frillip/gps-vfd-desk-clock/hardware/v2_0/smol_clock_2_0_bom_top.xlsx

No. | Quantity | Comment | Designator | Footprint | Value | Manufacturer Part | Manufacturer | Supplier Part | Supplier
1 | 2 | 100nF | C9,C25 | C0805 |  | CL21B104KCFNNNE | SAMSUNG(三星) | C28233 | LCSC
2 | 2 | 100nF | C33,C34 | C0402 |  | CL05B104KO5NNNC | SAMSUNG(三星) | C1525 | LCSC
3 | 1 | 2.54-2*4P立贴针 | H1 | HDR-SMD_8P-P2.54-V-M-R2-C4-LS7.4 |  | 2.54-2*4P立贴针 | BOOMELE(博穆精密) | C192300 | LCSC
4 | 4 | IV-12 VFD Tube_2MM | N1,N2,N3,N4 | IV-12 VFD TUBE 2MM PINS
5 | 2 | IV-1 VFD Tube | N5,N6 | IV-1
6 | 2 | 12Ω | R7,R8 | R0805 |  | AS05W2J0120T5E | UNI-ROYAL(厚声) | C966145 | LCSC
7 | 2 | HV5812WG-G | U9,U10 | SOIC-28_L18.0-W7.5-P1.27-LS10.3-BL |  | HV5812WG-G | Microchip Tech | C219183 | LCSC
