frillip/gps-vfd-desk-clock/hardware/v2_0/smol_clock_2_0_bom_bottom.xlsx

No. | Quantity | Comment | Designator | Footprint | Value | Manufacturer Part | Manufacturer | Supplier Part | Supplier
1 | 6 | JUMPER | 3V3_LED,E_LED,G_LED,S_LED,VG_LED,VU_LED | PAD-JUMPER-2-NC_BY_TRACE_YES_SILK
2 | 1 | BUZZER 9.6MM | BUZZER1 | BUZ-TH_BD9.6-P5.00-D0.7-FD
3 | 29 | 100nF | C1,C2,C4,C5,C7,C10,C11,C13,C14,C15,C16,C18,C20,C23,C24,C26,C28,C29,C30,C31,C36,C37,C38,C39,C42,C43,C44,C45,C52 | C0402 |  | CL05B104KO5NNNC | SAMSUNG(三星) | C1525 | LCSC
4 | 1 | 22uF | C3 | C0603 |  | CL10A226MQ8NRNC | SAMSUNG(三星) | C59461 | LCSC
5 | 1 | 10uF | C6 | CAP-SMD_BD6.3-L6.6-W6.6-FD |  | RVT2A100M0607 | ROQANG(容强) | C72482 | LCSC
6 | 2 | 100nF | C8,C51 | C0805 |  | CL21B104KCFNNNE | SAMSUNG(三星) | C28233 | LCSC
7 | 1 | 47pF | C12 | C0402 |  | 0402CG470J500NT | FH(风华) | C1567 | LCSC
8 | 1 | 10uF | C17 | CAP-SMD_L3.2-W1.6-R-RD |  | TC212A106K016Y | Sunlord | C108529 | LCSC
9 | 2 | 1uF | C19,C21 | C0603 |  | CL10A105KB8NNNC | SAMSUNG(三星) | C15849 | LCSC
10 | 1 | 100pF | C22 | C0402 |  | 500R07N101JV4T | JOHANSON(约翰逊) | C431654 | LCSC
11 | 2 | 4.7uF | C27,C50 | C0603 |  | CL10A475KO8NNNC | SAMSUNG(三星) | C19666 | LCSC
12 | 3 | 22uF | C32,C46,C47 | C0805 |  | CL21A226MAQNNNE | SAMSUNG(三星) | C45783 | LCSC
13 | 1 | 390pF | C35 | C0402 |  | CC0402KRX7R9BB391 | YAGEO(国巨) | C114397 | LCSC
14 | 2 | 22nF | C40,C41 | C0402 |  | CC0402KRX7R9BB223 | YAGEO(国巨) | C107026 | LCSC
15 | 2 | 10uF | C48,C49 | C0603 |  | CL10A106MA8NRNC | SAMSUNG(三星) | C96446 | LCSC
16 | 1 | HARWIN S8411-45R | CR1220 | HARWIN_S8411-45R |  | S8411-45R | HARWIN | 2115306 | Element14
17 | 2 | 1N5819WS | D1,D6 | SOD-323_L1.8-W1.3-LS2.5-RD |  | 1N5819WS | Hottech(合科泰) | C191023 | LCSC
18 | 2 | SP0503BAHTG | D2,D3 | SOT-143_L2.9-W1.3-P1.92-LS2.3-BR |  | SP0503BAHTG | Littelfuse(美国力特) | C7074 | LCSC
19 | 2 | PSBD1DF40V2L | D4,D9 | SOD-123FL_L2.8-W1.8-LS3.8-RD |  | PSBD1DF40V2L | Prisemi(芯导) | C496544 | LCSC
20 | 1 | PESD0402-140 | D5 | D0402-BI |  | PESD0402-140 | Littelfuse(美国力特) | C10662 | LCSC
21 | 1 | TC2030-NL-FTDI-TTL-232R | ESP | TC2030-IDC-NL |  | TC2030-NL-FTDI-TTL-232R | Tag-Connect | TC2030-NL-FTDI-TTL-232R | TAG-CONNECT
22 | 2 | JUMPER | G_RX,G_TX | SMT-JUMPER_2_NO_SILK
23 | 1 | PM254V-12-08-H85_C2834799 | H2 | HDR-TH_8P-P2.54-V-F-R2-C4-S2.54 |  | PM254V-12-08-H85 | XFCN(台湾兴飞) | C2834799 | LCSC
24 | 1 | 47nH | L1 | L0402 |  | LQW15AN47NG00D | muRata(村田) | C22334 | LCSC
25 | 2 | 3.3uH | L2,L3 | IND-SMD_L2.5-W2.0 |  | SPM2512-3R3M | KOHERelec(科或) | C2761860 | LCSC
26 | 1 | 15uH | L4 | IND-SMD_L5.0-W5.0 |  | FNR5040S150MT | cjiang(长江微电) | C167969 | LCSC
27 | 5 | 19-217/R6C-AL1M2VY/3T | LED1,LED3,LED4,LED5,LED7 | LED0603-R-RD |  | 19-217/R6C-AL1M2VY/3T | EVERLIGHT | C72044 | LCSC
28 | 1 | 19-217/BHC-ZL1M2RY/3T | LED2 | LED0603-FD_BLUE |  | 19-217/BHC-ZL1M2RY/3T | EVERLIGHT(亿光) | C72041 | LCSC
29 | 1 | TC2030-MCP-NL-10 NO PCB LINES | PICKIT | TC2030-IDC-NL |  | TC2030-MCP-NL-10 | Tag-Connect LLC | TC2030-MCP-NL-10-ND | Digi-Key
30 | 1 | BC847BDW1T1G | Q1 | SOT-363_L2.0-W1.3-P0.65-LS2.1-TL |  | BC847BDW1T1G | onsemi(安森美) | C82368 | LCSC
31 | 1 | AO3400A | Q2 | SOT-23-3_L2.9-W1.6-P1.90-LS2.8-BR |  | AO3400A | AOS | C20917 | LCSC
32 | 8 | 1kΩ | R1,R6,R12,R13,R14,R33,R49,R52 | R0603 |  | 0603WAF1001T5E | UNI-ROYAL(厚声) | C21190 | LCSC
33 | 1 | 10Ω | R2 | R0603 |  | RT0603DRD0710RL | YAGEO(国巨) | C700510 | LCSC
34 | 5 | 5.1kΩ | R3,R24,R25,R26,R47 | R0402 |  | 0402WGF5101TCE | UNI-ROYAL(厚声) | C25905 | LCSC
35 | 4 | 10kΩ | R4,R5,R9,R10 | R0402 |  | 0402WGF1002TCE | UniOhm | C25744 | LCSC
36 | 3 | 4.7kΩ | R15,R16,R31 | R0402 |  | 0402WGF4701TCE | UNI-ROYAL(厚声) | C25900 | LCSC
37 | 4 | 33Ω | R17,R18,R19,R20 | R0402 |  | 0402WGF330JTCE | UNI-ROYAL(厚声) | C25105 | LCSC
38 | 4 | 27Ω | R21,R22,R40,R41 | R0402 |  | 0402WGF270JTCE | UNI-ROYAL(厚声) | C25100 | LCSC
39 | 1 | 100kΩ | R23 | R0402 |  | 0402WGF1003TCE | UNI-ROYAL(厚声) | C25741 | LCSC
40 | 1 | 22kΩ | R27 | R0805 |  | 0805W8F2202T5E | UNI-ROYAL(厚声) | C17560 | LCSC
41 | 1 | 274kΩ | R28 | R0402 |  | 0402WGF2743TCE | UNI-ROYAL(厚声) | C27004 | LCSC
42 | 8 | 10kΩ | R29,R32,R36,R37,R42,R44,R50,R53 | R0402 |  | 0402WGF1002TCE | UNI-ROYAL(厚声) | C25744 | LCSC
43 | 1 | 8.87kΩ | R30 | R0402 |  | 0402WGF8871TCE | UNI-ROYAL(厚声) | C36953 | LCSC
44 | 4 | 0Ω | R34,R35,R38,R39 | R0402 |  | 0402WGF0000TCE | UNI-ROYAL(厚声) | C17168 | LCSC
45 | 1 | 38.3kΩ | R43 | R0402 |  | 0402WGF3832TCE | UNI-ROYAL(厚声) | C26976 | LCSC
46 | 1 | 47.5kΩ | R45 | R0402 |  | 0402WGF4752TCE | UNI-ROYAL(厚声) | C25896 | LCSC
47 | 1 | 22.1kΩ | R46 | R0402 |  | 0402WGF2212TCE | UNI-ROYAL(厚声) | C43473 | LCSC
48 | 1 | 330Ω | R48 | R0402 |  | 0402WGF3300TCE | UNI-ROYAL(厚声) | C25104 | LCSC
49 | 1 | 17.4kΩ | R51 | R0402 |  | 0402WGF1742TCE | UNI-ROYAL(厚声) | C26957 | LCSC
50 | 1 | 1kΩ | R54 | R0402 |  | 0402WGF1001TCE | UNI-ROYAL(厚声) | C11702 | LCSC
51 | 1 | BWSMA-KE-P001 | RF1 | SMA-SMD_BWSMA-KE-P001_0.5MMPIN |  | BWSMA-KE-P001 | BAT WIRELESS(蝙蝠无线) | C496550 | LCSC
52 | 1 | TS-1093A-A10B3-D2 | SW1 | KEY-TH_4P-L7.1-W11.4-P4.50-LS2.5 |  | TS-1093A-A10B3-D2 | Yuandi | C499317 | LCSC
53 | 1 | K3-1260D-F1 | SW2 | SW-TH_K3-1260D-F1 |  | K3-1260D-F1 | Korean Hroparts Elec | C223843 | LCSC
54 | 1 | SN74AHC1G04DBVR | U1 | SOT-23-5_L3.0-W1.7-P0.95-LS2.8-BR |  | SN74AHC1G04DBVR | TI | C7465 | LCSC
55 | 1 | LM3671MFX-3.3/NOPB | U2 | SOT-23-5_L3.0-W1.7-P0.95-LS2.8-BL |  | LM3671MFX-3.3/NOPB | TI(德州仪器) | C477918 | LCSC
56 | 1 | DSPIC33EP64GP504-I/PT | U3 | TQFP-44_L10.0-W10.0-P0.80-LS12.0-BL |  | DSPIC33EP64GP504-I/PT | MICROCHIP(美国微芯) | C1337713 | LCSC
57 | 1 | SN74LV4T125PWR | U4 | TSSOP-14_L5.0-W4.4-P0.65-LS6.4-BL |  | SN74LV4T125PWR | TI(德州仪器) | C90755 | LCSC
58 | 1 | TPS55340RTER | U5 | VQFN-16_L3.0-W3.0-P0.50-BL-EP1.7 |  | TPS55340RTER | TI(德州仪器) | C169167 | LCSC
59 | 1 | PCF8563TS/5,118 | U6 | TSSOP-8_L3.0-W3.0-P0.65-LS4.9-BL |  | PCF8563TS/5,118 | NXP(恩智浦) | C27397 | LCSC
60 | 1 | ESP32-WROOM-32E(16MB) | U7 | WIFI-SMD_ESP32-WROOM-32E |  | ESP32-WROOM-32E-N16 | ESPRESSIF(乐鑫) | C701343 | LCSC
61 | 1 | BME280 | U8 | LGA-8_BME280_BL |  | BME280 | Bosch(博世) | C92489 | LCSC
62 | 1 | CP2102N-A02-GQFN28R | U11 | QFN-28_L5.0-W5.0-P0.50-TL-EP3.3 |  | CP2102N-A02-GQFN28R | SILICON LABS(芯科) | C964632 | LCSC
63 | 1 | SN74LVC1G32DBVR | U12 | SOT-23-5_L3.0-W1.7-P0.95-LS2.8-BR |  | SN74LVC1G32DBVR | TI | C10096 | LCSC
64 | 1 | SN74AHCT1G04DBVR | U13 | SOT-23-5_L3.0-W1.7-P0.95-LS2.8-BR |  | SN74AHCT1G04DBVR | TI | C30326 | LCSC
65 | 1 | VEML6040A3OG | U14 | SENSOR_SMD_VEML6040A3OG |  | VEML6040A3OG | VISHAY(威世) | C78465 | LCSC
66 | 1 | LM2831ZMF/NOPB | U15 | SOT-23-5_L2.9-W1.6-P0.95-LS2.8-BR |  | LM2831ZMF/NOPB | TI(德州仪器) | C2070726 | LCSC
67 | 1 | TPS2113ADRBR | U16 | SON-8_L3.0-W3.0-P0.65-LS3.0-BL-EP |  | TPS2113ADRBR | TI(德州仪器) | C354512 | LCSC
68 | 1 | NEO-M9N | U21 | NEO-M9N |  | NEO-M9N | UBLOX | NEO-M9N | UBLOX
69 | 1 | HC-TYPE-C-16P-01A-L | USB1 | USB-C-SMD_G-SWITCH_GT-USB-7010EN |  | HC-TYPE-C-16P-01A-L | HCTL(华灿天禄) | C2997432 | LCSC
70 | 1 | HC-TYPE-C-16P-01A-O | USB2 | USB-C-SMD_G-SWITCH_GT-USB-7010EN |  | HC-TYPE-C-16P-01A-O | HCTL(华灿天禄) | C2997434 | LCSC
71 | 1 | 32.768kHz | X1 | FC-12M_L2.0-W1.2 |  | X1A0000610006 | EPSON(爱普生) | C99009 | LCSC
72 | 1 | 40MHz | X2 | OSC-SMD_4P-L5.0-W3.2-BL_SG-8101CB |  | SG-8101CB 40.000000MHz TBGSA | EPSON(爱普生) | C390561 | LCSC
