frillip/gps-vfd-desk-clock/hardware/v2_0/smol_clock_2_0_schematic.pdf

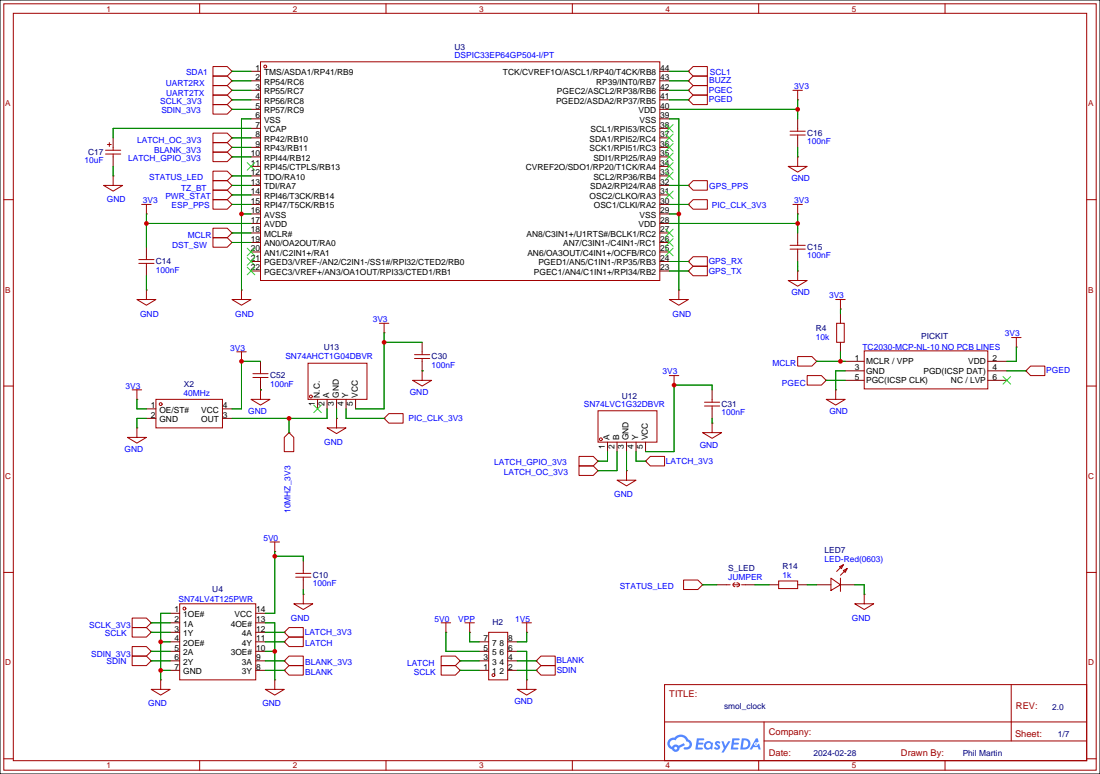
[picture p1: page 1]

TC2030-MCP-NL-10 NO PCB LINES

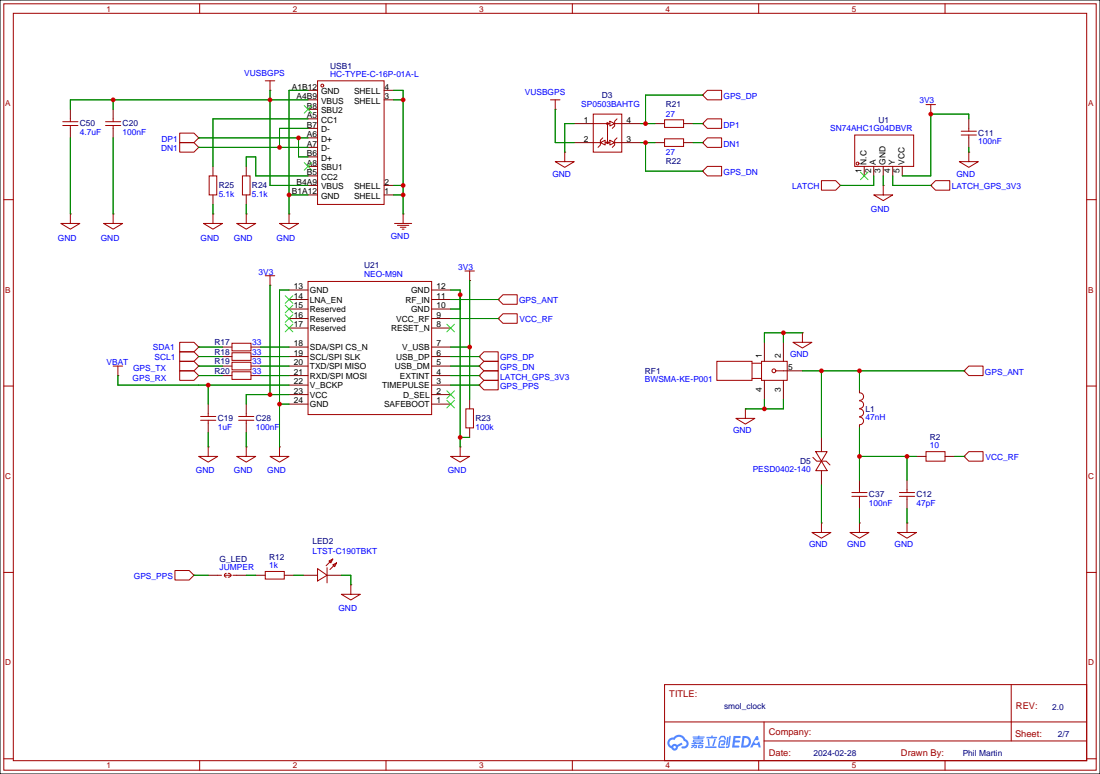
[picture p2: page 2]

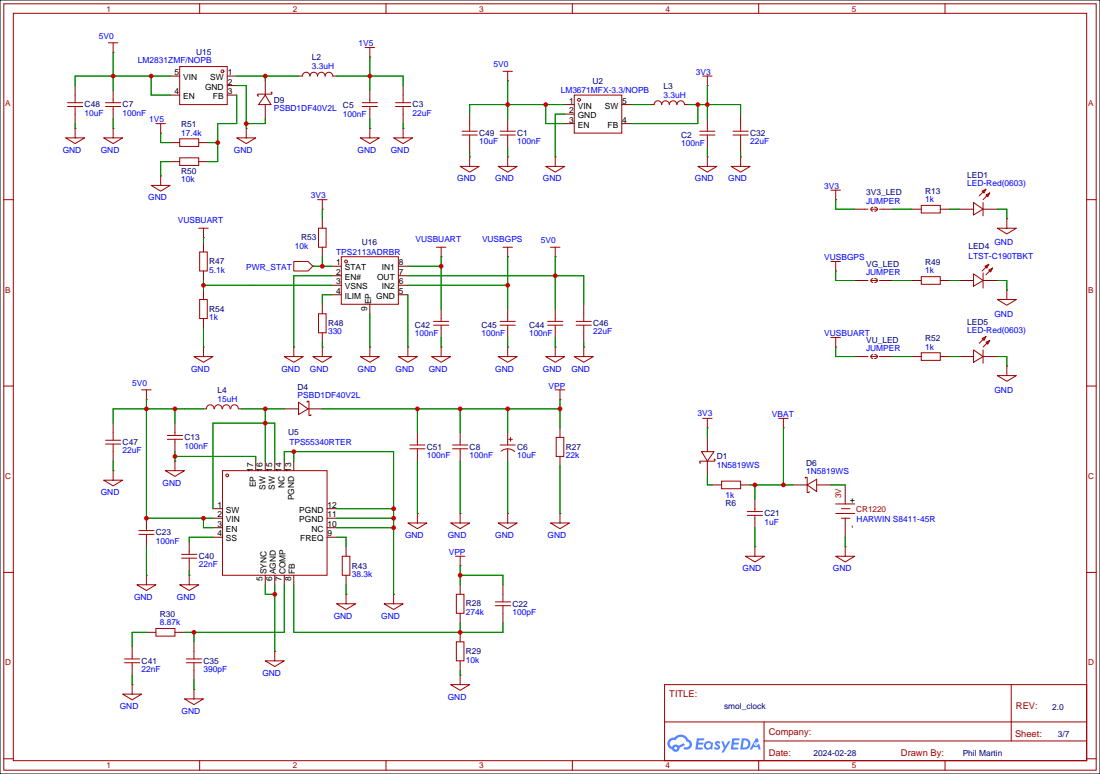
[picture p3: page 3]

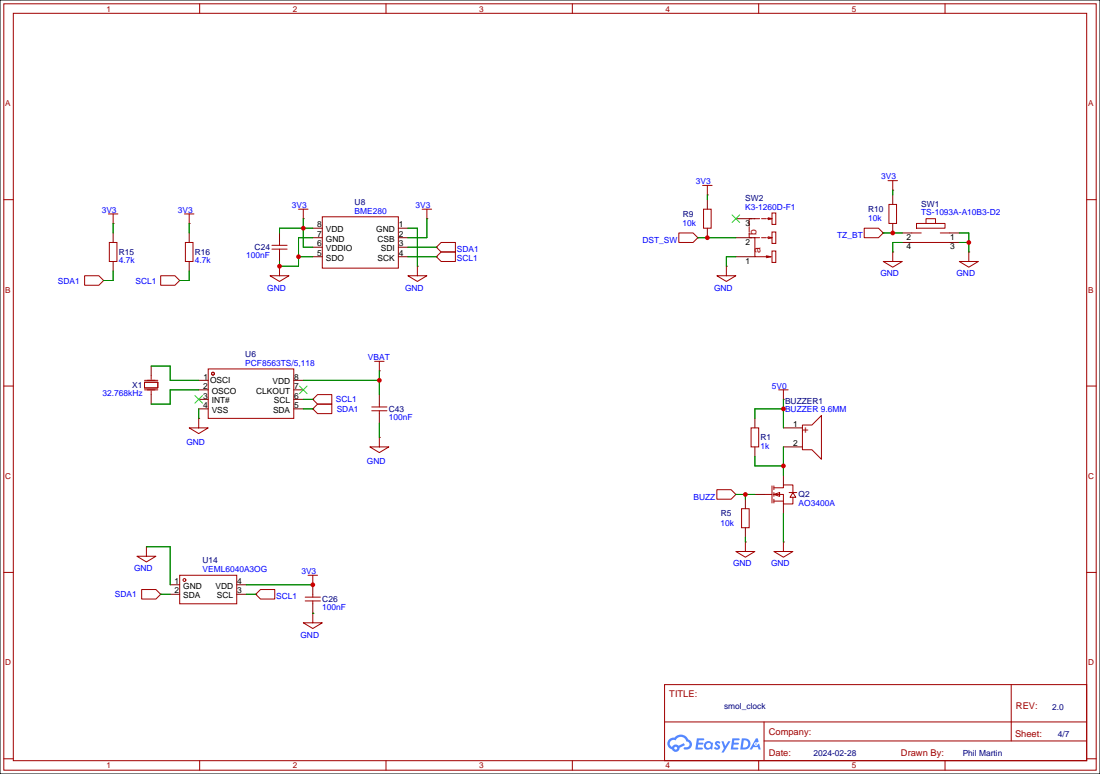
[picture p4: page 4]

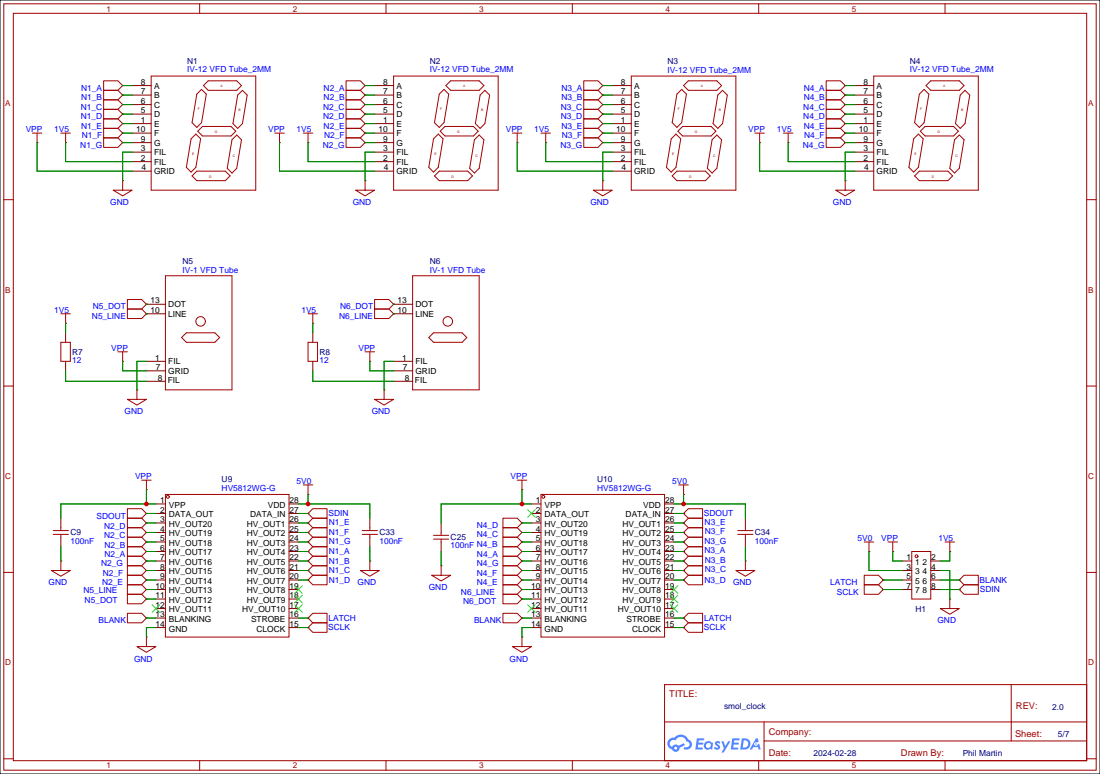
[picture p5: page 5]

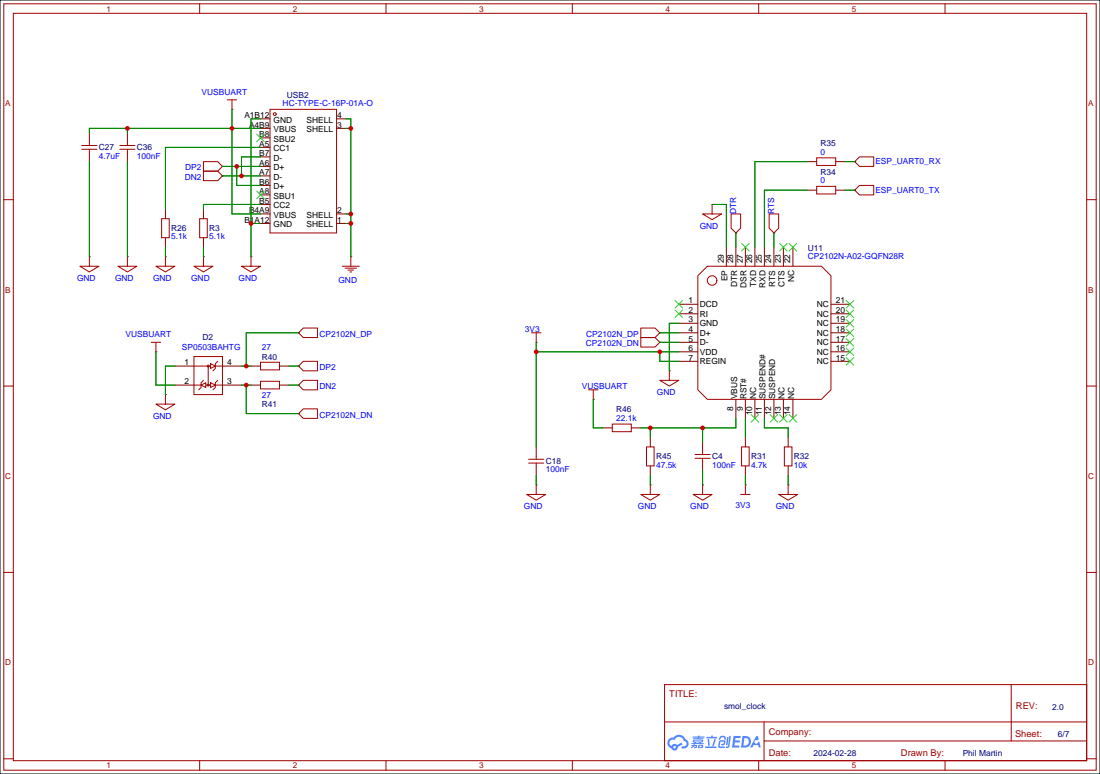
[picture p6: page 6]

CP2102N-A02-GQFN28R

NC 22 CTS 23 RTS 24 RXD 25 TXD 26 DSR 27 DTR 28 EP 29

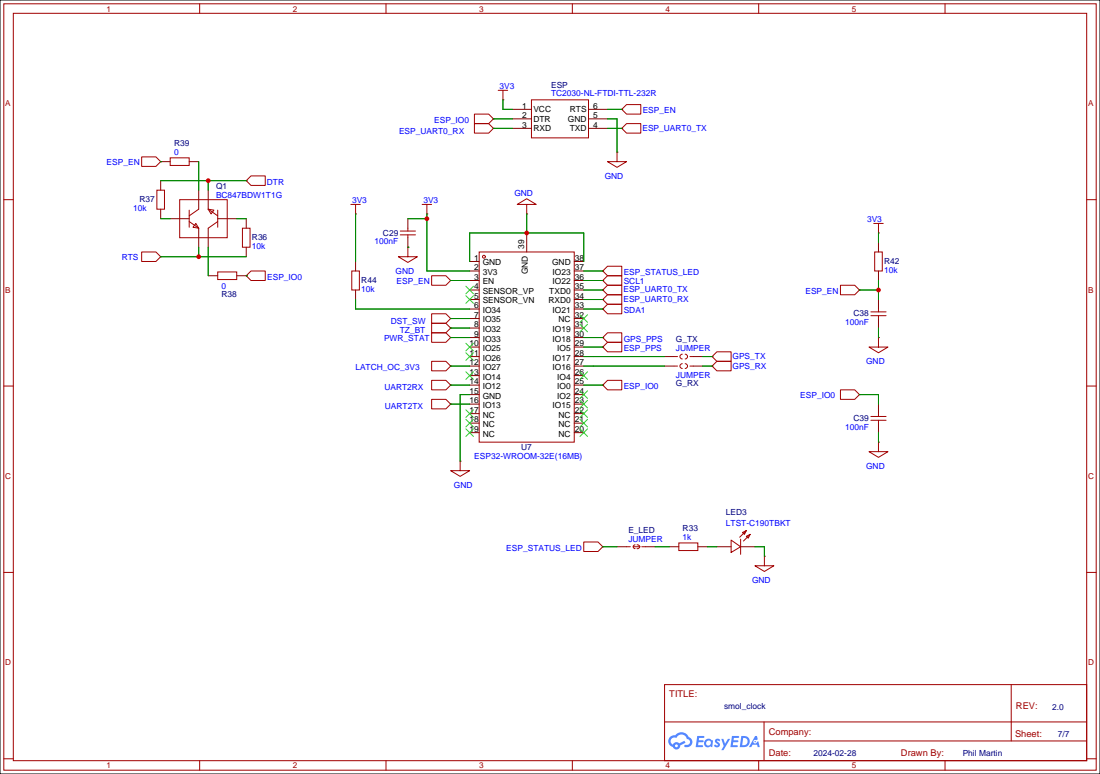
[picture p7: page 7]
