frillip/gps-vfd-desk-clock/esp_src/esp_src.ino

/*
 * Smol Clock V2 ESP32: network co-processor for the dsPIC timekeeper.
 *
 *   src/pic/       SML link to the PIC (pic_link), its state (pic_report);
 *                  sml/ links to the shared SML codec in common/
 *   src/timing/    NTP client and clock model, ESP PPS out, edge captures
 *   src/tz/        tzinfo v1 -> SML-TZ-STATE, TIME-LEAP
 *   src/net/       Wi-Fi, telnet, OTA updates, STAT-NET
 *   src/console/   console lines and commands (serial and telnet)
 *   src/settings/  NVS settings
 *   src/common/    links to the repository's common/
 *
 * Everything runs from loop(), except the NTP exchanges (their own task)
 * and the edges (interrupts). Blocking work (HTTP, OTA) holds up loop()
 * only: the ESP PPS runs on in its interrupt, and the PIC link's 4 KB
 * receive buffer holds several seconds of PIC traffic.
 */
#include <Arduino.h>

#include "src/board.h"
#include "src/console/commands.h"
#include "src/console/console.h"
#include "src/net/net_status.h"
#include "src/net/telnet.h"
#include "src/net/updater.h"
#include "src/net/wifi_link.h"
#include "src/pic/pic_link.h"
#include "src/settings/user_prefs.h"
#include "src/timing/ntp.h"
#include "src/timing/pps.h"
#include "src/tz/leap.h"
#include "src/tz/tzinfo.h"
#include "src/version.h"

#define LED_PULSE_MS 100U
// While the NTP servers disagree, each pulse is two short flashes.
#define LED_FLASH_MS 40U
#define LED_GAP_MS   80U
#define MINUTE_MS    60000U

static ConsoleLine serial_line;
static uint32_t led_on_ms;
static bool led_double;
static uint32_t last_minute_ms;

void setup()
{
    Serial.begin(BOARD_CONSOLE_BAUD);
    Serial.printf("\nSmol Clock ESP %s (reset: %s)\n", ESP_VERSION, commands_reset_reason());
    pinMode(BOARD_STATUS_LED_PIN, OUTPUT);
    digitalWrite(BOARD_STATUS_LED_PIN, LOW);

    user_prefs_init(&Serial);
    pps_init();
    pic_link_init();
    pic_link_set_command_handler(commands_from_pic);
    wifi_link_init(&Serial);
    telnet_init(&Serial);
    ntp_init();
    tzinfo_init(&Serial);
    Serial.print("> ");
}


// Each ESP PPS edge: TIME-NTP to the PIC, and the status LED while synced:
// one flash, or two while the NTP servers disagree.
static void service_ntp_report(void)
{
    SML_TIME_NTP_PAYLOAD report;

    if (!ntp_take_report(&report))
    {
        return;
    }
    pic_link_send(SML_CLASS_TIME, SML_TIME_NTP, &report);
    if (ntp_is_synced() && wifi_link_is_up())
    {
        digitalWrite(BOARD_STATUS_LED_PIN, HIGH);
        led_on_ms = millis();
        led_double = ntp_servers_disagree();
    }
}


void loop()
{
    bool network_up;

    pic_link_service();
    wifi_link_service();
    network_up = wifi_link_is_up();
    ntp_service(network_up);
    service_ntp_report();
    tzinfo_service(network_up);
    leap_service();
    net_status_service();

    if (console_read_line(&serial_line, &Serial, true))
    {
        commands_execute(&Serial, serial_line.text);
        console_line_clear(&serial_line);
        Serial.print("> ");
    }
    telnet_service();

    if (led_on_ms != 0)
    {
        uint32_t lit_ms = millis() - led_on_ms;

        if (!led_double && lit_ms >= LED_PULSE_MS)
        {
            digitalWrite(BOARD_STATUS_LED_PIN, LOW);
            led_on_ms = 0;
        }
        else if (led_double)
        {
            bool on = lit_ms < LED_FLASH_MS || (lit_ms >= LED_FLASH_MS + LED_GAP_MS &&
                                                lit_ms < 2 * LED_FLASH_MS + LED_GAP_MS);

            digitalWrite(BOARD_STATUS_LED_PIN, on ? HIGH : LOW);
            if (lit_ms >= 2 * LED_FLASH_MS + LED_GAP_MS)
            {
                led_on_ms = 0;
            }
        }
    }
    if (network_up && millis() - last_minute_ms >= MINUTE_MS)
    {
        uint32_t local;
        bool have_local = tzinfo_local_now(&local);

        last_minute_ms = millis();
        updater_service(have_local, local);
    }
}
