frillip/gps-vfd-desk-clock/esp_src/serial_console.cpp

#include "serial_console.h"

extern USER_PREFS_DATA_STRUCT user_prefs;

Stream *last_output_stream = &Serial;

const char* serial_console_help_text = R"EOF(
esp-reset = Reset the ESP
esp-ntp-set-interval [n] = Set NTP interval to [n] (min 300, max 43200)
esp-ntp-set-server [s] = Set the NTP server to [s]
esp-ntp-resync = Force NTP sync
esp-wifi-info = Print WiFi info
esp-wifi-scan = Scan for and print WiFi networks
esp-wifi-connect = Force WiFi connect
esp-wifi-disconnect = Force WiFi disconnect
esp-wifi-ssid [s] = Set the saved SSID to [s]
esp-wifi-pass [s] = Set the saved passphrase to [s]
esp-wifi-dhcp [b] = Enable/disable DHCP (0 / 1)
esp-wifi-ip [s] = Set static IP to [s], unless [s] is 'dhcp' or 'auto'
esp-wifi-mask [s] = Set ip mask to [s], only valid with static IP
esp-wifi-gateway [s] = Set gateway to [s], only valid with static IP
esp-wifi-clear = Clear saved WiFi config
esp-wifi-setup = Enable WiFi setup AP mode

esp-tzinfo-enable = Enable remote timezone information functionality
esp-tzinfo-disable = Disable remote timezone information functionality
esp-tzinfo-check = Pull timezone information from the tzinfo server but don't update anything
esp-tzinfo-update = Update the timezone information from the tzinfo server
esp-tzinfo-set-server [s] = Set the tzinfo server hostname
esp-tzinfo-set-path [s] = Set the tzinfo server request path
esp-tzinfo-set-interval [n] = Set the tzinfo checking interval to [n] seconds (300 - 86400)
esp-tzinfo-set-acc [n] = Set the precision of GNSS coordinates sent to the server in decimal places (0 - 6, or -1 to disable)

esp-telnet-enable = Enable the telnet console
esp-telnet-disable = Disable the telnet console
esp-telnet-start = Start the telnet console
esp-telnet-stop = Stop the telnet console
esp-telnet-port [n] = Change the telnet port number (1 - 65535)

esp-update-check = Check for an OTA update
esp-update-pull = Check for and perform an OTA update if available
esp-update-force = Force and OTA update, regardless of version, and install immediately
esp-update-set-server [s] = Set update server hostname
esp-update-set-path [s] = Set update server path
esp-update-set-config [s] = Sets the specific config string (eg. development), use 'default' to remove
esp-update-auto-enable = Enables automatic updates
esp-update-auto-disable = Disables automatic updates
esp-update-auto-hour [n] = Sets the hour the ESP will check for and install updates (0 - 23)

esp-config-show = Print all settings
esp-config-clear = Clear user preferences in ESP
esp-clear-all = Clear all ESP settings including WiFi
esp-save = Save settings

pic-info = Show info directly from PIC
pic-resync = Force resync of the PIC with GNSS PPS or NTP
pic-reset = Resets the PIC
pic-set-rtc [n] = Set PIC delta epoch to [n] unix epoch time
pic-set-tz-offset [n] = Set timezone offset to [n] in seconds, rounds to nearest 15 minutes
pic-set-dst-offset [n] = Set dst offset to [n] in seconds, rounds to nearest 15 minutes
pic-set-dst-auto [b] = Enable/disable auto dst
pic-set-dst-active [b] = Enable/disable dst (pic-set-dst-auto must be off)
pic-set-alarm-enabled [b] = Enable/disable alarm
pic-set-alarm [n] = Set PIC alarm to [n] seconds past midnight
pic-set-delta [n] = Set PIC delta epoch to [n] unix epoch time
pic-set-fosc-freq [n] = Manually set PIC Fosc frequency to n
pic-set-beeps [b] = Enable/disable beeping
pic-set-display [e] = Set pic display to [e]: 1=HHMM, 2=MMSS, 3=SSMM, 4=YYYY, 5=MMDD
pic-set-brightness-auto = Set display brightness to auto
pic-set-brightness [n] = Set display brightness to n / 4000
pic-eeprom-show = show settings stored in EEPROM
pic-config-show = show running config settings
pic-config-clear = Clear all settings to defaults
pic-save = Save settings
pic-bootloader-enter = Enter bootloader on PIC
pic-bootloader-exit = Exit bootloader on PIC

rst-all = Reset both
rst-pic = Same as pic-reset
rst-esp = Same as esp-reset

help = show this text
help x = Print help for the command x

\n = print available data
)EOF";

USER_CMD_TYPE serial_console_check_1(const char *cmd_buf)
{
  if(strncmp(cmd_buf, USER_CMD_STAGE_1_ESP_STRING, USER_CMD_STAGE_1_LENGTH) == 0)
  {
    return USER_CMD_TYPE_ESP;
  }
  else if(strncmp(cmd_buf, USER_CMD_STAGE_1_PIC_STRING, USER_CMD_STAGE_1_LENGTH) == 0)
  {
    return USER_CMD_TYPE_PIC;
  }
  else if(strncmp(cmd_buf, USER_CMD_STAGE_1_RST_STRING, USER_CMD_STAGE_1_LENGTH) == 0)
  {
    return USER_CMD_TYPE_RST;
  }
  else if(strncmp(cmd_buf, USER_CMD_STAGE_1_HELP_STRING, USER_CMD_STAGE_1_LENGTH) == 0)
  {
    return USER_CMD_TYPE_HELP;
  }
  return USER_CMD_TYPE_NONE;
}


USER_CMD serial_console_check_2_esp(const char *cmd_buf)
{
  // Check if chars 5-10 are "wifi-"
  if(strncmp(cmd_buf + USER_CMD_STAGE_1_LENGTH, USER_CMD_ESP_WIFI_PREFIX_STRING, USER_CMD_ESP_WIFI_PREFIX_LENGTH) == 0)
  {
    if(strcmp(cmd_buf, USER_CMD_ESP_WIFI_INFO_STRING) == 0)
    {
      return USER_CMD_ESP_WIFI_INFO;
    }

    if(strcmp(cmd_buf, USER_CMD_ESP_WIFI_SCAN_STRING) == 0)
    {
      return USER_CMD_ESP_WIFI_SCAN;
    }

    if(strcmp(cmd_buf, USER_CMD_ESP_WIFI_CONNECT_STRING) == 0)
    {
      return USER_CMD_ESP_WIFI_CONNECT;
    }

    if(strcmp(cmd_buf, USER_CMD_ESP_WIFI_DISCONNECT_STRING) == 0)
    {
      return USER_CMD_ESP_WIFI_DISCONNECT;
    }

    if(strcmp(cmd_buf, USER_CMD_ESP_WIFI_SSID_STRING) == 0)
    {
      return USER_CMD_ESP_WIFI_SSID;
    }

    if(strcmp(cmd_buf, USER_CMD_ESP_WIFI_PASS_STRING) == 0)
    {
      return USER_CMD_ESP_WIFI_PASS;
    }

    if(strcmp(cmd_buf, USER_CMD_ESP_WIFI_DHCP_STRING) == 0)
    {
      return USER_CMD_ESP_WIFI_DHCP;
    }

    if(strcmp(cmd_buf, USER_CMD_ESP_WIFI_IP_STRING) == 0)
    {
      return USER_CMD_ESP_WIFI_IP;
    }

    if(strcmp(cmd_buf, USER_CMD_ESP_WIFI_MASK_STRING) == 0)
    {
      return USER_CMD_ESP_WIFI_MASK;
    }

    if(strcmp(cmd_buf, USER_CMD_ESP_WIFI_GATEWAY_STRING) == 0)
    {
      return USER_CMD_ESP_WIFI_GATEWAY;
    }

    if(strcmp(cmd_buf, USER_CMD_ESP_WIFI_CLEAR_STRING) == 0)
    {
      return USER_CMD_ESP_WIFI_CLEAR;
    }

    if(strcmp(cmd_buf, USER_CMD_ESP_WIFI_SETUP_STRING) == 0)
    {
      return USER_CMD_ESP_WIFI_SETUP;
    }
  }
  else
  {
    if(strcmp(cmd_buf, USER_CMD_ESP_RESET_STRING) == 0)
    {
      return USER_CMD_ESP_RESET;
    }

    if(strcmp(cmd_buf, USER_CMD_ESP_NTP_INFO_STRING) == 0)
    {
      return USER_CMD_ESP_NTP_INFO;
    }

    if(strcmp(cmd_buf, USER_CMD_ESP_NTP_SET_INTERVAL_STRING) == 0)
    {
      return USER_CMD_ESP_NTP_SET_INTERVAL;
    }

    if(strcmp(cmd_buf, USER_CMD_ESP_NTP_SET_SERVER_STRING) == 0)
    {
      return USER_CMD_ESP_NTP_SET_SERVER;
    }

    if(strcmp(cmd_buf, USER_CMD_ESP_NTP_RESYNC_STRING) == 0)
    {
      return USER_CMD_ESP_NTP_RESYNC;
    }

    if(strcmp(cmd_buf, USER_CMD_ESP_UPDATE_CHECK_STRING) == 0)
    {
      return USER_CMD_ESP_UPDATE_CHECK;
    }

    if(strcmp(cmd_buf, USER_CMD_ESP_UPDATE_PULL_STRING) == 0)
    {
      return USER_CMD_ESP_UPDATE_PULL;
    }

    if(strcmp(cmd_buf, USER_CMD_ESP_UPDATE_FORCE_STRING) == 0)
    {
      return USER_CMD_ESP_UPDATE_FORCE;
    }

    if(strcmp(cmd_buf, USER_CMD_ESP_UPDATE_SET_SERVER_STRING) == 0)
    {
      return USER_CMD_ESP_UPDATE_SET_SERVER;
    }

    if(strcmp(cmd_buf, USER_CMD_ESP_UPDATE_SET_PATH_STRING) == 0)
    {
      return USER_CMD_ESP_UPDATE_SET_PATH;
    }

    if(strcmp(cmd_buf, USER_CMD_ESP_UPDATE_SET_CONFIG_STRING) == 0)
    {
      return USER_CMD_ESP_UPDATE_SET_CONFIG;
    }

    if(strcmp(cmd_buf, USER_CMD_ESP_UPDATE_AUTO_ENABLE_STRING) == 0)
    {
      return USER_CMD_ESP_UPDATE_AUTO_ENABLE;
    }

    if(strcmp(cmd_buf, USER_CMD_ESP_UPDATE_AUTO_DISABLE_STRING) == 0)
    {
      return USER_CMD_ESP_UPDATE_AUTO_DISABLE;
    }

    if(strcmp(cmd_buf, USER_CMD_ESP_UPDATE_AUTO_HOUR_STRING) == 0)
    {
      return USER_CMD_ESP_UPDATE_AUTO_HOUR;
    }

    if(strcmp(cmd_buf, USER_CMD_ESP_TZINFO_ENABLE_STRING) == 0)
    {
      return USER_CMD_ESP_TZINFO_ENABLE;
    }

    if(strcmp(cmd_buf, USER_CMD_ESP_TZINFO_DISABLE_STRING) == 0)
    {
      return USER_CMD_ESP_TZINFO_DISABLE;
    }

    if(strcmp(cmd_buf, USER_CMD_ESP_TZINFO_CHECK_STRING) == 0)
    {
      return USER_CMD_ESP_TZINFO_CHECK;
    }

    if(strcmp(cmd_buf, USER_CMD_ESP_TZINFO_UPDATE_STRING) == 0)
    {
      return USER_CMD_ESP_TZINFO_UPDATE;
    }

    if(strcmp(cmd_buf, USER_CMD_ESP_TZINFO_SET_SERVER_STRING) == 0)
    {
      return USER_CMD_ESP_TZINFO_SET_SERVER;
    }

    if(strcmp(cmd_buf, USER_CMD_ESP_TZINFO_SET_PATH_STRING) == 0)
    {
      return USER_CMD_ESP_TZINFO_SET_PATH;
    }

    if(strcmp(cmd_buf, USER_CMD_ESP_TZINFO_SET_INTERVAL_STRING) == 0)
    {
      return USER_CMD_ESP_TZINFO_SET_INTERVAL;
    }

    if(strcmp(cmd_buf, USER_CMD_ESP_TZINFO_SET_ACC_STRING) == 0)
    {
      return USER_CMD_ESP_TZINFO_SET_ACC;
    }

    if(strcmp(cmd_buf, USER_CMD_ESP_TELNET_ENABLE_STRING) == 0)
    {
      return USER_CMD_ESP_TELNET_ENABLE;
    }

    if(strcmp(cmd_buf, USER_CMD_ESP_TELNET_DISABLE_STRING) == 0)
    {
      return USER_CMD_ESP_TELNET_DISABLE;
    }

    if(strcmp(cmd_buf, USER_CMD_ESP_TELNET_START_STRING) == 0)
    {
      return USER_CMD_ESP_TELNET_START;
    }

    if(strcmp(cmd_buf, USER_CMD_ESP_TELNET_STOP_STRING) == 0)
    {
      return USER_CMD_ESP_TELNET_STOP;
    }

    if(strcmp(cmd_buf, USER_CMD_ESP_TELNET_PORT_STRING) == 0)
    {
      return USER_CMD_ESP_TELNET_PORT;
    }

    if(strcmp(cmd_buf, USER_CMD_ESP_CONFIG_SHOW_STRING) == 0)
    {
      return USER_CMD_ESP_CONFIG_SHOW;
    }

    if(strcmp(cmd_buf, USER_CMD_ESP_CONFIG_CLEAR_STRING) == 0)
    {
      return USER_CMD_ESP_CONFIG_CLEAR;
    }

    if(strcmp(cmd_buf, USER_CMD_ESP_CLEAR_ALL_STRING) == 0)
    {
      return USER_CMD_ESP_CLEAR_ALL;
    }

    if(strcmp(cmd_buf, USER_CMD_ESP_SAVE_STRING) == 0)
    {
      return USER_CMD_ESP_SAVE;
    }
  }
  return USER_CMD_NONE;
}


USER_CMD serial_console_check_2_pic(const char *cmd_buf)
{
    if(strcmp(cmd_buf, USER_CMD_PIC_INFO_STRING) == 0)
    {
      return USER_CMD_PIC_INFO;
    }

    if(strcmp(cmd_buf, USER_CMD_PIC_RESYNC_STRING) == 0)
    {
      return USER_CMD_PIC_RESYNC;
    }

    if(strcmp(cmd_buf, USER_CMD_PIC_RESET_STRING) == 0)
    {
      return USER_CMD_PIC_RESET;
    }

    if(strcmp(cmd_buf, USER_CMD_PIC_SET_RTC_STRING) == 0)
    {
      return USER_CMD_PIC_SET_RTC;
    }

    if(strcmp(cmd_buf, USER_CMD_PIC_SET_TZ_OFFSET_STRING) == 0)
    {
      return USER_CMD_PIC_SET_TZ_OFFSET;
    }

    if(strcmp(cmd_buf, USER_CMD_PIC_SET_DST_OFFSET_STRING) == 0)
    {
      return USER_CMD_PIC_SET_DST_OFFSET;
    }

    if(strcmp(cmd_buf, USER_CMD_PIC_SET_DST_AUTO_STRING) == 0)
    {
      return USER_CMD_PIC_SET_DST_AUTO;
    }

    if(strcmp(cmd_buf, USER_CMD_PIC_SET_DST_ACTIVE_STRING) == 0)
    {
      return USER_CMD_PIC_SET_DST_ACTIVE;
    }

    if(strcmp(cmd_buf, USER_CMD_PIC_SET_FOSC_FREQ_STRING) == 0)
    {
      return USER_CMD_PIC_SET_FOSC_FREQ;
    }
    
    if(strcmp(cmd_buf, USER_CMD_PIC_SET_ALARM_ENABLED_STRING) == 0)
    {
      return USER_CMD_PIC_SET_ALARM_ENABLED;
    }

    if(strcmp(cmd_buf, USER_CMD_PIC_SET_ALARM_STRING) == 0)
    {
      return USER_CMD_PIC_SET_ALARM;
    }

    if(strcmp(cmd_buf, USER_CMD_PIC_SET_DELTA_STRING) == 0)
    {
      return USER_CMD_PIC_SET_DELTA;
    }

    if(strcmp(cmd_buf, USER_CMD_PIC_SET_BEEPS_STRING) == 0)
    {
      return USER_CMD_PIC_SET_BEEPS;
    }

    if(strcmp(cmd_buf, USER_CMD_PIC_SET_DISPLAY_STRING) == 0)
    {
      return USER_CMD_PIC_SET_DISPLAY;
    }

    if(strcmp(cmd_buf, USER_CMD_PIC_SET_BRIGHTNESS_AUTO_STRING) == 0)
    {
      return USER_CMD_PIC_SET_BRIGHTNESS_AUTO;
    }

    if(strcmp(cmd_buf, USER_CMD_PIC_SET_BRIGHTNESS_STRING) == 0)
    {
      return USER_CMD_PIC_SET_BRIGHTNESS;
    }

    if(strcmp(cmd_buf, USER_CMD_PIC_SHOW_EEPROM_STRING) == 0)
    {
      return USER_CMD_PIC_SHOW_EEPROM;
    }

    if(strcmp(cmd_buf, USER_CMD_PIC_SHOW_CONFIG_STRING) == 0)
    {
      return USER_CMD_PIC_SHOW_CONFIG;
    }

    if(strcmp(cmd_buf, USER_CMD_PIC_CLEAR_ALL_STRING) == 0)
    {
      return USER_CMD_PIC_CLEAR_ALL;
    }

    if(strcmp(cmd_buf, USER_CMD_PIC_SAVE_STRING) == 0)
    {
      return USER_CMD_PIC_SAVE;
    }

    if(strcmp(cmd_buf, USER_CMD_PIC_BOOTLOADER_ENTER_STRING) == 0)
    {
      return USER_CMD_PIC_BOOTLOADER_ENTER;
    }

    if(strcmp(cmd_buf, USER_CMD_PIC_BOOTLOADER_EXIT_STRING) == 0)
    {
      return USER_CMD_PIC_BOOTLOADER_EXIT;
    }

  return USER_CMD_NONE;
}


USER_CMD serial_console_check_2_rst(const char *cmd_buf)
{
  if(strcmp(cmd_buf, USER_CMD_RESET_ALL_STRING) == 0)
  {
    return USER_CMD_RESET_ALL;
  }
  if(strcmp(cmd_buf, USER_CMD_RESET_ESP_STRING) == 0)
  {
    return USER_CMD_ESP_RESET;
  }
  if(strcmp(cmd_buf, USER_CMD_RESET_PIC_STRING) == 0)
  {
    return USER_CMD_PIC_RESET;
  }
  return USER_CMD_NONE;
}


USER_CMD serial_console_check_2_help(const char *cmd_buf)
{
  if(strcmp(cmd_buf, USER_CMD_HELP_STRING) == 0)
  {
    return USER_CMD_HELP;
  }
  return USER_CMD_NONE;
}

void serial_console_help(Stream *output) // To do: Help text per command? Or let them suffer? (const char *arg_buf)
{
  serial_console_print_help_all(output);
  /*
  if(arg_buf[0] == 0x00)
  {
    serial_console_print_help_all();
  }
  else
  {
    // To do: Help text per command? Or let them suffer?
    serial_console_print_help_all();
  }
  */
}

void serial_console_print_help_all(Stream *output)
{
  output->printf(serial_console_help_text);
}


void serial_console_exec(Stream *output, USER_CMD cmd, const char *arg_buf)
{
  switch(cmd)
  {
    case USER_CMD_NONE:
      break;

    case USER_CMD_ESP_RESET:
      output->println("ESP resetting");
      ESP.restart(); // And reset
      break;

    case USER_CMD_ESP_NTP_INFO:
      print_ntp_info(output);
      break;

    case USER_CMD_ESP_NTP_SET_INTERVAL:
      uint32_t ntp_interval_new;
      if(serial_console_validate_uint32(arg_buf, &ntp_interval_new))
      {
        //extern uint32_t ntp_interval;
        output->printf("Setting NTP resync to %u\n", ntp_interval_new);
        user_prefs.fields.ntp.interval = ntp_interval_new;
        setInterval(user_prefs.fields.ntp.interval);
      }
      break;

    case USER_CMD_ESP_NTP_SET_SERVER:
      time_t tmp;
      uint32_t tmp2;
      strlcpy(user_prefs.fields.ntp.server, arg_buf, sizeof(user_prefs.fields.ntp.server));
      if(queryNTP(String(user_prefs.fields.ntp.server), tmp, tmp2))
      {
        setServer(String(user_prefs.fields.ntp.server));
        output->printf("New NTP server: %s\n", arg_buf);
      }
      else
      {
        output->printf("NTP error: %s\nNTP server unchanged!\n", errorString(error(true)).c_str());
      }
      break;

    case USER_CMD_ESP_NTP_RESYNC:
      output->printf("Manual NTP resync\n");
      updateNTP();
      scheduler_unsync();
      esp_pps_unsync();
      break;

    case USER_CMD_ESP_WIFI_INFO:
      sercon_print_wifi(output);
      break;

    case USER_CMD_ESP_WIFI_SCAN:
      sercon_print_ssids(output);
      break;

    case USER_CMD_ESP_WIFI_CONNECT:
      output->printf("ESP reconnecting to WiFi\n");
      WiFi.reconnect();
      break;

    case USER_CMD_ESP_WIFI_DISCONNECT:
      output->printf("ESP disconnecting from WiFi\n");
      WiFi.disconnect();
      break;

    case USER_CMD_ESP_WIFI_SSID:
      output->printf("Not implemented yet :(\n");
      break;

    case USER_CMD_ESP_WIFI_PASS:
      output->printf("Not implemented yet :(\n");
      break;

    case USER_CMD_ESP_WIFI_DHCP:
      output->printf("Not implemented yet :(\n");
      break;

    case USER_CMD_ESP_WIFI_IP:
      output->printf("Not implemented yet :(\n");
      break;

    case USER_CMD_ESP_WIFI_MASK:
      output->printf("Not implemented yet :(\n");
      break;

    case USER_CMD_ESP_WIFI_GATEWAY:
      output->printf("Not implemented yet :(\n");
      break;

    case USER_CMD_ESP_WIFI_CLEAR:
      {
        extern WiFiManager wm;
        output->printf("ESP clearing WiFi config\n");
        wm.resetSettings(); // Delete WiFi credentials
        ESP.restart(); // And reset
      }
      break;

    case USER_CMD_ESP_WIFI_SETUP:
      {
        extern WiFiManager wm;
        output->printf("ESP clearing WiFi config\n");
        wm.resetSettings(); // Delete WiFi credentials
        ESP.restart(); // And reset
      }
      break;

    case USER_CMD_ESP_UPDATE_CHECK:
      updater_check(output);
      break;

    case USER_CMD_ESP_UPDATE_PULL:
      updater_pull(output);
      break;

    case USER_CMD_ESP_UPDATE_FORCE:
      updater_force(output);
      break;

    case USER_CMD_ESP_UPDATE_SET_SERVER:
      updater_set_server(arg_buf);
      output->printf("New update server: %s\n", arg_buf);
      break;

    case USER_CMD_ESP_UPDATE_SET_PATH:
      updater_set_path(arg_buf);
      output->printf("New update path: %s\n", arg_buf);
      break;

    case USER_CMD_ESP_UPDATE_SET_CONFIG:
      updater_set_config(arg_buf);
      output->printf("New update config: %s\n", arg_buf);
      break;

    case USER_CMD_ESP_UPDATE_AUTO_ENABLE:
      output->printf("Auto update enabled\n");
      user_prefs.fields.updater.flags.auto_enabled = 1;
      break;

    case USER_CMD_ESP_UPDATE_AUTO_DISABLE:
      output->printf("Auto update disabled\n");
      user_prefs.fields.updater.flags.auto_enabled = 0;
      break;

    case USER_CMD_ESP_UPDATE_AUTO_HOUR:
      uint32_t updater_auto_check_local_hour_new;
      if(serial_console_validate_uint32(arg_buf, &updater_auto_check_local_hour_new))
      {
        if((updater_auto_check_local_hour_new >= UPDATE_AUTO_CHECK_LOCAL_HOUR_MIN) && (updater_auto_check_local_hour_new <= UPDATE_AUTO_CHECK_LOCAL_HOUR_MAX))
        {
          output->printf("Setting auto update time to %02u:00\n", updater_auto_check_local_hour_new);
          user_prefs.fields.updater.flags.auto_time = updater_auto_check_local_hour_new;
        }
        else
        {
          output->printf("Invalid range (%u - %u)\n", UPDATE_AUTO_CHECK_LOCAL_HOUR_MIN, UPDATE_AUTO_CHECK_LOCAL_HOUR_MAX);
          user_prefs.fields.updater.flags.auto_time = updater_auto_check_local_hour_new;
        }
      }
      break;


    case USER_CMD_ESP_TZINFO_ENABLE:
      output->printf("Remote tzinfo enabled\n");
      user_prefs.fields.rtzinfo.flags.enabled = 1;
      break;

    case USER_CMD_ESP_TZINFO_DISABLE:
      output->printf("Remote tzinfo disabled\n");
      user_prefs.fields.rtzinfo.flags.enabled = 0;
      extern uint32_t remote_tzinfo_interval_count;
      remote_tzinfo_interval_count = REMOTE_TZINFO_INTERVAL_MAX + 1; // Set this so that it checks immediately on enable
      break;

    case USER_CMD_ESP_TZINFO_CHECK:
      remote_tzinfo_check(output);
      extern bool tzinfo_available;
      tzinfo_available = 0;
      break;

    case USER_CMD_ESP_TZINFO_UPDATE:
      remote_tzinfo_check(output);
      break;

    case USER_CMD_ESP_TZINFO_SET_SERVER:
      remote_tzinfo_set_server(arg_buf);
      output->printf("New tzinfo server: %s\n", arg_buf);
      break;

    case USER_CMD_ESP_TZINFO_SET_PATH:
      remote_tzinfo_set_path(arg_buf);
      output->printf("New tzinfo path: %s\n", arg_buf);
      break;

    case USER_CMD_ESP_TZINFO_SET_INTERVAL:
      uint32_t remote_tzinfo_interval_new;
      if(serial_console_validate_uint32(arg_buf, &remote_tzinfo_interval_new))
      {
        if((remote_tzinfo_interval_new >= REMOTE_TZINFO_INTERVAL_MIN) && (remote_tzinfo_interval_new <= REMOTE_TZINFO_INTERVAL_MAX))
        {
          output->printf("Setting tzinfo interval to %us\n", remote_tzinfo_interval_new);
          user_prefs.fields.rtzinfo.interval = remote_tzinfo_interval_new;
        }
        else
        {
          output->printf("Invalid range (%u - %u)\n", REMOTE_TZINFO_INTERVAL_MIN, REMOTE_TZINFO_INTERVAL_MAX);
        }
      }
      break;

    case USER_CMD_ESP_TZINFO_SET_ACC:
      int32_t remote_tzinfo_gnss_accuracy_new;
      if(serial_console_validate_int32(arg_buf, &remote_tzinfo_gnss_accuracy_new))
      {
        if(remote_tzinfo_gnss_accuracy_new == REMOTE_TZINFO_GNSS_ACCURACY_MIN)
        {
          output->printf("GNSS information for tzinfo disabled\n");
          user_prefs.fields.rtzinfo.gnss_accuracy = remote_tzinfo_gnss_accuracy_new;
        }
        else if((remote_tzinfo_gnss_accuracy_new > REMOTE_TZINFO_GNSS_ACCURACY_MIN) && (remote_tzinfo_gnss_accuracy_new <= REMOTE_TZINFO_GNSS_ACCURACY_MAX))
        {
          output->printf("Setting tzinfo accuracy to %u decimal places\n", remote_tzinfo_gnss_accuracy_new);
          user_prefs.fields.rtzinfo.gnss_accuracy = remote_tzinfo_gnss_accuracy_new;
        }
        else
        {
          output->printf("Invalid accuracy range (%i - %i decimal places, or %i to disable)\n", REMOTE_TZINFO_GNSS_ACCURACY_MIN + 1, REMOTE_TZINFO_GNSS_ACCURACY_MAX, REMOTE_TZINFO_GNSS_ACCURACY_MIN);
        }
      }
      break;

    case USER_CMD_ESP_TELNET_ENABLE:
      telnet_enable(output);
      break;

    case USER_CMD_ESP_TELNET_DISABLE:
      telnet_disable(output);
      break;

    case USER_CMD_ESP_TELNET_START:
      telnet_start(output);
      break;

    case USER_CMD_ESP_TELNET_STOP:
      telnet_stop(output);
      break;

    case USER_CMD_ESP_TELNET_PORT:
      uint32_t telnet_port_new;
      if(serial_console_validate_uint32(arg_buf, &telnet_port_new))
      {
        if((telnet_port_new >= 1) && (telnet_port_new <= 65535))
        {
          output->printf("Setting telnet port to %u\n", telnet_port_new);
          telnet_set_port(output, telnet_port_new);
        }
        else
        {
          output->printf("Invalid port (1 - 65535)\n");
        }
      }
      break;

    case USER_CMD_ESP_CONFIG_SHOW:
      user_prefs_print(output);
      break;

    case USER_CMD_ESP_CONFIG_CLEAR:
      bool telnet_enable_old;
      telnet_enable_old = user_prefs.fields.telnet.flags.enabled;
      output->printf("ESP clearing user preferences\n");
      user_prefs_reset();
      user_prefs_print(output);
      if(telnet_enable_old && !user_prefs.fields.telnet.flags.enabled)
      {
        output->printf("\nWARNING: telnet is now disabled!\nUse \"esp-telnet-enable\" to re-enable\n");
      }
      break;

    case USER_CMD_ESP_CLEAR_ALL:
      {
        output->printf("ESP clearing user preferences\n");
        user_prefs_reset();
        user_prefs_print(output);
        user_prefs_save();

        extern WiFiManager wm;
        output->printf("ESP clearing WiFi config\n");
        wm.resetSettings(); // Delete WiFi credentials

        output->printf("Resetting...");
        ESP.restart(); // And reset
      }
      break;

    case USER_CMD_ESP_SAVE:
      user_prefs_save();
      output->printf("ESP user preferences saved\n");
      break;

    case USER_CMD_PIC_INFO:
      pic_uart_tx_userdata(cmd, 0, output);
      break;

    case USER_CMD_PIC_RESYNC:
      pic_uart_tx_userdata(cmd, 0, output);
      break;

    case USER_CMD_PIC_RESET:
      pic_uart_tx_userdata(cmd, 0, output);
      break;

    case USER_CMD_PIC_SET_RTC:
      // time_t values are implemented as uint32_t in XC16, not int32_t
      uint32_t rtc_val_new;
      if(serial_console_validate_uint32(arg_buf, &rtc_val_new))
      {
        pic_uart_tx_userdata(cmd, rtc_val_new, output);
      }
      break;

    case USER_CMD_PIC_SET_TZ_OFFSET:
      int32_t tz_offset_val_new;
      if(serial_console_validate_int32(arg_buf, &tz_offset_val_new))
      {
        pic_uart_tx_userdata(cmd, tz_offset_val_new, output);
      }
      break;

    case USER_CMD_PIC_SET_DST_OFFSET:
      uint32_t dst_offset_val_new;
      if(serial_console_validate_uint32(arg_buf, &dst_offset_val_new))
      {
        pic_uart_tx_userdata(cmd, dst_offset_val_new, output);
      }
      break;

    case USER_CMD_PIC_SET_DST_AUTO:
      output->printf("Not implemented yet :(\n");
      break;

    case USER_CMD_PIC_SET_DST_ACTIVE:
      output->printf("Not implemented yet :(\n");
      break;

    case USER_CMD_PIC_SET_FOSC_FREQ:
      uint32_t fosc_freq_val_new;
      if(serial_console_validate_uint32(arg_buf, &fosc_freq_val_new))
      {
        pic_uart_tx_userdata(cmd, fosc_freq_val_new, output);
      }
      break;

    case USER_CMD_PIC_SET_ALARM_ENABLED:
      output->printf("Not implemented yet :(\n");
      break;

    case USER_CMD_PIC_SET_ALARM:
      output->printf("Not implemented yet :(\n");
      break;

    case USER_CMD_PIC_SET_DELTA:
      // time_t values are implemented as uint32_t in XC16, not int32_t
      uint32_t delta_val_new;
      if(serial_console_validate_uint32(arg_buf, &delta_val_new))
      {
        pic_uart_tx_userdata(cmd, delta_val_new, output);
      }
      break;

    case USER_CMD_PIC_SET_BEEPS:
      output->printf("Not implemented yet :(\n");
      break;

    case USER_CMD_PIC_SET_DISPLAY:
      output->printf("Not implemented yet :(\n");
      break;

    case USER_CMD_PIC_SET_BRIGHTNESS_AUTO:
      pic_uart_tx_userdata(cmd, 0, output);
      break;

    case USER_CMD_PIC_SET_BRIGHTNESS:
      uint32_t brightness;
      if(serial_console_validate_uint32(arg_buf, &brightness))
      {
        pic_uart_tx_userdata(cmd, brightness, output);
      }
      break;

    case USER_CMD_PIC_SHOW_EEPROM:
      pic_uart_tx_userdata(cmd, 0, output);
      break;

    case USER_CMD_PIC_SHOW_CONFIG:
      pic_uart_tx_userdata(cmd, 0, output);
      break;

    case USER_CMD_PIC_CLEAR_ALL:
      pic_uart_tx_userdata(cmd, 0, output);
      break;

    case USER_CMD_PIC_SAVE:
      pic_uart_tx_userdata(cmd, 0, output);
      break;

    case USER_CMD_PIC_BOOTLOADER_ENTER:
      pic_enter_bootloader(output);
      break;

    case USER_CMD_PIC_BOOTLOADER_EXIT:
      pic_exit_bootloader(output);
      break;

    case USER_CMD_RESET_ALL:
      pic_uart_tx_userdata(USER_CMD_PIC_RESET, 0, output);
      ESP.restart();
      break;
  }
}

void sercon_print_wifi(Stream *output)
{
  wifi_config_t cachedConfig;
  esp_err_t configResult = esp_wifi_get_config( (wifi_interface_t)ESP_IF_WIFI_STA, &cachedConfig );
      
  if( configResult == ESP_OK )
  {
      output->printf("WiFi: %s%s%s\n",
               (WiFi.status() == WL_CONNECTED) ? ANSI_BLACK_GREEN : ANSI_BLACK_RED,
               (WiFi.status() == WL_CONNECTED) ? "CONNECTED" : "DISCONNECTED",
               ANSI_RESET);
      output->printf("SSID: %s\n", cachedConfig.ap.ssid);
      output->printf("PSK: %s\n", cachedConfig.ap.password);
      output->printf("IP: %s\n", WiFi.localIP().toString().c_str());
  }
  else
  {
      output->printf( "esp_wifi_get_config returned %i", configResult );
  }
  output->printf("\n");
}

void sercon_print_ssids(Stream *output)
{
  wifi_config_t cachedConfig;
  esp_err_t configResult = esp_wifi_get_config( (wifi_interface_t)ESP_IF_WIFI_STA, &cachedConfig );

  output->printf("Scan start\n");
  // WiFi.scanNetworks will return the number of networks found
  int n = WiFi.scanNetworks();
  output->print("Scan done\n");

  if (n == 0)
  {
    output->printf("No networks found\n");
  } else
  {
    output->printf("%i networks found:\n",n);
    for (int i = 0; i < n; ++i)
    {
      bool connected_network = 0;
      if(strcmp((const char*)cachedConfig.ap.ssid, WiFi.SSID(i).c_str()) == 0)
      {
        connected_network = 1;
      }
      // Print SSID and RSSI for each network found
      if(connected_network) output->printf("%s", ANSI_BLACK_GREEN);
      output->printf(" %s (%i)", WiFi.SSID(i).c_str(), WiFi.RSSI(i));

      switch(WiFi.encryptionType(i))
      {
        case WIFI_AUTH_OPEN:
          output->printf("     OPEN");
          break;

        case WIFI_AUTH_WEP:
          output->printf("      WEP");
          break;

        case WIFI_AUTH_WPA_PSK:
          output->printf("  WPA-PSK");
          break;

        case WIFI_AUTH_WPA2_PSK:
        case WIFI_AUTH_WPA_WPA2_PSK:
          output->printf(" WPA2-PSK");
          break;

        case WIFI_AUTH_WPA2_WPA3_PSK:
        case WIFI_AUTH_WPA3_PSK:
          output->printf("  WPA3-PSK");
          break;

        case WIFI_AUTH_ENTERPRISE:
          output->printf("  WPA-EAP");
          break;

/* // Same value as WIFI_AUTH_ENTERPRISE above
        case WIFI_AUTH_WPA2_ENTERPRISE:
          output->printf(" WPA2-EAP");
          break;
*/

/*  // Not defined in arduino esp32 yet
        //case WIFI_AUTH_WPA2_WPA3_ENTERPRISE:
        case WIFI_AUTH_WPA2_WPA3_ENTERPRISE :
          output->printf(" WPA3-EAP");
          break;
*/

        default:
          output->printf("   OTHER");
          break;
      }
      if(connected_network) output->printf(" (connected)%s", ANSI_RESET);
      output->printf("\n");
    }
  }
  output->printf("\n");
}


void print_ntp_info(Stream *output)
{
  time_t now = UTC.now();
  //extern uint32_t ntp_interval;
  output->printf("NTP time:  ");
  print_iso8601_string(output, now);
  if(WiFi.status() != WL_CONNECTED)
  {
    output->printf(" - NO WIFI");
  }
  else if(timeStatus() != timeSync)
  {
    output->printf(" - NO NTP SYNC");
  }
  output->printf("\nServer:    %s\n", user_prefs.fields.ntp.server);
  output->printf("Interval:  %u\n", user_prefs.fields.ntp.interval);
  output->printf("Last sync: ");
  print_iso8601_string(output, lastNtpUpdateTime());
  output->printf("\n");
}


void serial_console_print_info(Stream *output)
{
  output->printf("\n");
  print_pic_time(output);
  
  if(gnss_is_detected() && timeStatus() != timeNotSet)
  {
    print_gnss_pps_offset(output);
  }
  if(pic_is_detected() && timeStatus() != timeNotSet)
  {
    print_pic_pps_offset(output);
  }
  if(pic_is_detected() && gnss_is_detected() && timeStatus() != timeNotSet)
  {
    print_pic_pps_relative_offset(output);
  }
  
  print_offset_data(output);
  output->printf("\n=== NTP ===\n");
  print_ntp_info(output);
  print_gnss_data(output);
  print_remote_tzinfo(output);
  print_rtc_data(output);
  print_veml_data(output);
  print_bme_data(output);
  print_sync_state_machine(output);
}

/*
uint32_t local_print_millis = 0;

void serial_console_second_changed(uint32_t millis)
{
  local_print_millis = millis;
}


bool serial_console_print_local_available(void)
{
  // Disable this for now
  return 0;

  if(local_print_millis)
  {
    if(millis() > (local_print_millis + LOCAL_TIME_PRINT_DELAY))
    {
      return 1;
    }
  }
  return 0;
}


void serial_console_print_local(void)
{
  extern time_t pic;
  if(millis() > (local_print_millis + LOCAL_TIME_PRINT_DELAY))
  {
    print_local_time(pic);
    output->println("");
    local_print_millis = 0;
  }
}
*/

bool serial_console_validate_uint32(const char* input, uint32_t* output)
{
  // Check if the input is null
  if (input == NULL)
  {
    return false;
  }

  uint32_t temp;
  // Parse
  int result = sscanf(input, "%ld", &temp);

  // Success?
  if (result == 1)
  {
    // Bounds check
    if (temp > UINT32_MAX)
    {
        return false;
    }
    // Store the parsed value in the output variable
    *output = temp;
    return true;
  }

  // If parsing failed, return false
  return false;
}

bool serial_console_validate_int32(const char* input, int32_t* output)
{
  // Check if the input is null
  if (input == NULL)
  {
    return false;
  }

  int32_t temp;
  // Parse
  int result = sscanf(input, "%ld", &temp);

  // Success?
  if (result == 1)
  {
    // Bounds check
    if (temp > INT32_MAX)
    {
        return false;
    }
    if (temp < INT32_MIN)
    {
        return false;
    }
    // Store the parsed value in the output variable
    *output = temp;
    return true;
  }

  // If parsing failed, return false
  return false;
}

bool serial_console_validate_bool(const char* input, bool* output)
{
  if (!input) return false;

  if (!strcmp(input, "1") ||
      !strcasecmp(input, "true") ||
      !strcasecmp(input, "on") ||
      !strcasecmp(input, "yes"))
  {
    *output = true;
    return true;
  }

  if (!strcmp(input, "0") ||
      !strcasecmp(input, "false") ||
      !strcasecmp(input, "off") ||
      !strcasecmp(input, "no"))
  {
    *output = false;
    return true;
  }

  return false;  // rejected
}
