frillip/gps-vfd-desk-clock/esp_src/src/net/telnet.cpp

#include "telnet.h"

#include <ESPTelnetStream.h>
#include <WiFi.h>
#include <lwip/sockets.h>

#include "../console/commands.h"
#include "../console/console.h"
#include "../settings/user_prefs.h"
#include "wifi_link.h"

static ESPTelnetStream telnet;
static bool running;
static ConsoleLine line;
// Console output waiting for the socket, sent from telnet_service().
#define TX_BUFFER_BYTES 8192U
static uint8_t tx_buffer[TX_BUFFER_BYTES];
static uint32_t tx_head; // next byte to send
static uint32_t tx_count;
static uint32_t pending_dropped; // bytes dropped since the last note
static uint32_t dropped_bytes;   // ... in all
static uint32_t connections;

static void tx_flush(void);
static uint32_t disconnections;

static void on_connect(String ip)
{
    Serial.printf("\nTelnet: %s connected\n", ip.c_str());
    telnet.printf("\nSmol Clock, %s\n(type 'quit' or 'exit' to disconnect)\n> ",
                  WiFi.getHostname());
    console_line_clear(&line);
    tx_head = 0;
    tx_count = 0;
    pending_dropped = 0;
    connections++;
}

static void on_disconnect(String ip)
{
    Serial.printf("Telnet: %s disconnected\n", ip.c_str());
    disconnections++;
}

static void on_reconnect(String ip)
{
    Serial.printf("\nTelnet: %s reconnected\n", ip.c_str());
}

static void on_attempt(String ip)
{
    Serial.printf("Telnet: %s tried to connect\n", ip.c_str());
}

void telnet_init(Stream *output)
{
    telnet.onConnect(on_connect);
    telnet.onConnectionAttempt(on_attempt);
    telnet.onReconnect(on_reconnect);
    telnet.onDisconnect(on_disconnect);
    if (user_prefs.fields.telnet.flags.enabled)
    {
        telnet_start(output);
    }
    else
    {
        output->printf("Telnet disabled, enable with \"telnet on\"\n");
    }
}

void telnet_service(void)
{
    if (!running)
    {
        return;
    }
    telnet.loop();
    if (!telnet.isConnected())
    {
        tx_count = 0;
        return;
    }
    tx_flush();
    if (console_read_line(&line, &telnet, false))
    {
        if (strcmp(line.text, "quit") == 0 || strcmp(line.text, "exit") == 0)
        {
            telnet.disconnectClient();
        }
        else
        {
            tx_flush(); // what came before, before the reply
            commands_execute(&telnet, line.text);
            telnet.print("> ");
        }
        console_line_clear(&line);
    }
}

// Its addresses and port: 192.0.2.5:23, [2001:db8::5]:23; or just the port
// without a network yet.
static void print_listening(Stream *output)
{
    if (wifi_link_is_up())
    {
        wifi_link_print_addresses(output, user_prefs.fields.telnet.port);
        output->printf("\n");
    }
    else
    {
        output->printf("port %u once the network is up\n", user_prefs.fields.telnet.port);
    }
}


void telnet_start(Stream *output)
{
    if (running)
    {
        output->printf("Telnet already running on ");
        print_listening(output);
        return;
    }
    // On :: : IPv6 and IPv4 (as IPv4-mapped) clients alike.
    telnet.begin(user_prefs.fields.telnet.port, false);
    running = true;
    output->printf("Telnet running, connect on ");
    print_listening(output);
}

void telnet_stop(Stream *output)
{
    if (!running)
    {
        output->printf("Telnet is not running\n");
        return;
    }
    output->printf("Telnet stopping; the current session stays open\n");
    if (user_prefs.fields.telnet.flags.enabled)
    {
        output->printf("It starts again at reset: turn that off with \"telnet off\"\n");
    }
    telnet.stop(false);
    running = false;
}

void telnet_enable(Stream *output)
{
    user_prefs.fields.telnet.flags.enabled = 1;
    output->printf("Telnet enabled\n");
    if (!running)
    {
        telnet_start(output);
    }
}

void telnet_disable(Stream *output)
{
    user_prefs.fields.telnet.flags.enabled = 0;
    output->printf("Telnet disabled%s\n",
                   running ? " but still running: stop it with \"telnet stop\"" : "");
}

void telnet_set_port(Stream *output, uint16_t port)
{
    if (port == user_prefs.fields.telnet.port)
    {
        return;
    }
    user_prefs.fields.telnet.port = port;
    if (running)
    {
        telnet_stop(output);
        telnet_start(output);
    }
}

bool telnet_is_running(void)
{
    return running;
}

Stream *telnet_client(void)
{
    return running && telnet.isConnected() ? &telnet : NULL;
}

// Into the buffer; what does not fit is dropped and counted.
static void buffer_text(const uint8_t *text, size_t length)
{
    uint32_t room = TX_BUFFER_BYTES - tx_count;
    uint32_t tail;
    size_t index;

    if (length > room)
    {
        pending_dropped += (uint32_t)(length - room);
        dropped_bytes += (uint32_t)(length - room);
        length = room;
    }
    tail = (tx_head + tx_count) % TX_BUFFER_BYTES;
    for (index = 0; index < length; index++)
    {
        tx_buffer[tail] = text[index];
        tail = (tail + 1) % TX_BUFFER_BYTES;
    }
    tx_count += (uint32_t)length;
}

void telnet_write_text(const uint8_t *text, size_t length)
{
    if (!running || !telnet.isConnected())
    {
        return;
    }
    if (pending_dropped != 0 && TX_BUFFER_BYTES - tx_count >= 48U + length)
    {
        char note[48];
        int n = snprintf(note, sizeof(note), "\r\n[telnet: %lu bytes dropped]\r\n",
                         (unsigned long)pending_dropped);

        pending_dropped = 0;
        buffer_text((const uint8_t *)note, (size_t)n);
    }
    buffer_text(text, length);
}

/*
 * As much of the buffer as the socket takes now, without waiting. One send
 * per pass of loop() gathers the many small writes of a burst (the PIC's
 * start-up text arrives a few bytes at a time) into full segments: lwIP
 * limits the segments queued as well as the bytes, so a send per piece ran
 * out of segments with the window still open.
 */
static void tx_flush(void)
{
    int fd;

    if (tx_count == 0)
    {
        return;
    }
    fd = telnet.getClient().fd();
    if (fd < 0)
    {
        return;
    }
    while (tx_count != 0)
    {
        uint32_t chunk =
            TX_BUFFER_BYTES - tx_head < tx_count ? TX_BUFFER_BYTES - tx_head : tx_count;
        ssize_t sent = send(fd, tx_buffer + tx_head, chunk, MSG_DONTWAIT);

        if (sent <= 0)
        {
            return; // no room now: try again next pass
        }
        tx_head = (tx_head + (uint32_t)sent) % TX_BUFFER_BYTES;
        tx_count -= (uint32_t)sent;
        if ((uint32_t)sent < chunk)
        {
            return;
        }
    }
}

void telnet_print(Stream *output, bool verbose)
{
    uint16_t port = user_prefs.fields.telnet.port;

    if (running && wifi_link_is_up())
    {
        output->printf("Telnet:   RUNNING ");
        wifi_link_print_addresses(output, port);
    }
    else
    {
        output->printf("Telnet:   %s, port %u", running ? "RUNNING, no network" : "STOPPED", port);
    }
    output->printf(", start-up %s", user_prefs.fields.telnet.flags.enabled ? "ON" : "OFF");
    if (running && telnet.isConnected())
    {
        output->printf(", client %s", telnet.getIP().c_str());
    }
    if (!verbose)
    {
        output->printf("\n");
        return;
    }
    output->printf(", %lu connections, %lu disconnections, %lu bytes dropped\n",
                   (unsigned long)connections, (unsigned long)disconnections,
                   (unsigned long)dropped_bytes);
}
