frillip/gps-vfd-desk-clock/(commit log)

2021-10-10 Initial commit Working: PPS input capture, PPS output compare, OC input capture, tube SPI driver, time.h, GPS parsing
2021-10-16 Update tubes.c
    Behaviour of indicator digit when running `display_mmss()` now matches `display_time()`
2021-10-16 Added scheduler
    Scheduler syncs with OC latch/reset pulse
    [main.c, scheduler.c, scheduler.h, system.c]
2021-10-17 Added support for DS1307 RTC
    Terminal screen now also clears on reboot. Welcome message added.
    [ds1307.c, ds1307.h, i2c1.c, main.c]
2021-10-18 Improved RTC handling
    Corrected some minor UART start conditions
    [main.c]
2021-10-22 Added clock switching PoC
    Starts with FRC, waits for RB lock, then switches to EC + PLL.
2021-10-23 Remove scheduler timer from MCC
2021-10-23 Added i2c timeout to ds1307
2021-10-23 Updated startup sequence
    Now greets the user before switching to Rb!
2021-10-24 Removed ADC from MCC
2021-10-24 Print GPS fix status
    [main.c]
2021-11-13 Added clock accumulation counter
    And debug flag to print information every second
2021-11-13 Tubes now flash whilst waiting for Rb lock
2021-11-19 Wait for Rb to power up
    Now pauses ~500ms after power on to wait for the Rb frequency ref to power up and assert OSC_READY state
2021-12-05 Now only update RTC when we have GPS Fix
    [main.c]
2022-02-10 Added option to manually print data
    With added cat protection
2022-02-20 Added FE5680A functionality
    Can calculate a new F= value for FE5680A option 58 units if given an accuracy value. Can currently obtain accuracy value by counting clock cycles vs GPS PPS signal
2022-02-27 Basic SC16IS7x0 driver
    Allows initialisation, reading of rx/tx FIFO buffer levels, sending/reading of individual characters and arrays of characters
2022-02-28 Added FE5680 trim funcs
    Can now read output of FE5680a to determine current F and R values, and load new values to the unit
2022-02-28 Update sc16is7x0.h
    Add forgotten function prototypes
2022-03-06 Update sc16is7x0.c
    Removed pointless printing of i2c buffer size
2022-04-02 Added print_ubx_data() function
    Added to gps.c to clean up main scheduler loop
2022-04-02 Added functions to clear i2c uart FIFOs
2023-07-17 Updated tubes functions for new hardware
2023-07-17 Removed PDO functions
    Crystal is not stable enough to use the PDO circuit
2023-07-17 SHT30 prototype code
    Nonworking... but based on working Arduino code. More work required to finish it.
2023-07-17 Update pic_pps.c
    Reorganised functions and added fix for OC 'stall' if the OC value was <65535. Adjustment takes place over a number of cycles now.
    [pic_pps.c]
2023-07-24 Enable WDT
    If the scheduler loop stops, or our OC doesn't fire for 32s, reset the device.
    [main.c, system.c]
2023-07-25 Added ability to reset device via serial
    [main.c]
2023-07-25 Fixed dumb uptime bug
    [pic_pps.c]
2023-07-26 Create ui.c and move print_iso8601_string function
2023-07-26 Use print_iso8601_string in RTC functions
2023-07-26 Rewrote buzzer code and moved to ui.c
    [main.c, ui.c, ui.h]
2023-07-27 Fix scheduler overflow on printing lots of data
    [main.c]
2023-07-27 Clean up loop and don't print data every min
2023-07-27 Move uart1 input to ui
2023-07-29 Only beep when switch is high!
    Overnight beeping is not appreciated by philistines
2023-07-30 Proper button/switch UI functions
    Button/switch inputs are now debounced for 20ms, and trigger display update when states changed.
    Helper functions also added. Start separator is updated based on debounced input state, just for testing for now.
2023-07-30 Pending update flag in tubes.c
2023-07-30 Fix dumb missing semicolon
    [ui.h]
2023-07-30 Overhaul tube display functions
2023-07-30 Fixed dumb button ui bug
    [ui.c]
2023-07-30 Tidy RTC functions
    Naming convention + switchable between DS1307 and PCF8563
2023-12-23 Brightness control
    Use OC3 for flicker-free brightness control of the tubes. 10kHz PWM into BLANK pin on HV5812
2023-12-28 Fixed rare OC sync bug
    Fixed occurrence where accumulated clock cycles would be below the threshold but OC offset would still be high. Now checks both accumulated clock cycles and OC offset.
    [pic_pps.c]
2023-12-29 More sync bug fixes
    [gnss_pps.c, pic_pps.c]
2023-12-30 Rename of variables in tubes.c
2023-12-30 Revert "Renames. Added init and detection funcs"
    This reverts commit 0fb08f71c49d563bdfaf0639803b6d654922d75e.
    [gnss.c, gnss.h]
2023-12-30 Revert "RTC detection"
    This reverts commit 83886c91a8c7d062ea75cdb4c52d9118140561d5.
    [rtc.c, rtc.h]
2024-01-01 New sync state for OC deviation only
    Does not recalculate frequency if slipped cycles < 2 * accumulated cycles
    [freq.h, sync_state.c, sync_state.h]
2024-01-01 Fixed new state bug
    Now properly checks negative conditions
    [freq.h, sync_state.c]
2024-01-01 Properly print OC count variable as unsigned
2024-01-03 New state machine states, sync oc bugfix
    [main.c, sync_state.c, sync_state.h, ui.c]
2024-01-12 Explicit declaration of sync limits
    Possible problem with negatives not being treated as such by compiler
    [freq.h]
2024-01-14 Now print RTC time has been updated
2024-01-14 More state machine updates
    Skeletons for NTP operation, waits in RTC mode for GNSS fix, writes RTC every 15 min
    [sync_state.c]
2024-01-14 Update RTC time after writing
    Should probably read this back instead, but i2c on dev board is questionable
2024-01-14 Fixed dumb pointer error
    [sync_state.c]
2024-01-14 Fixed long duration no sync bug
    New state machine state not accounted for!
    [sync_state.c]
2024-01-19 Button processing overhaul
2024-01-20 Lat/Lon no longer reversed
    [ublox_ubx.c]
2024-01-28 Add string.h to esp32.h includes
2024-01-28 Add ESP32 arduino src
2024-01-29 Use switch instead of obscene else if ladders
2024-01-30 Fix overflow in gnss buffer
    Reinitialise UART2 when calling gnss_init to clear buffer
    [gnss.c]
2024-01-30 Calculate short term avg slipped cycles
    [freq.h, gnss_pps.c, gnss_pps.h, pic_pps.c]
2024-01-30 Better short term accuracy
    Calculate rolling 10s average deviation. Reset OC/sync if >8 cycles average. Useful for temperature fluctuations that may get lost in long term average
    [freq.h, gnss_pps.c, gnss_pps.h, pic_pps.c, pic_pps.h, sync_state.c, sync_state.h]
2024-01-31 Better printing of average clocks
2024-01-31 Use switch in gnss uart function
2024-02-01 Optimised gnss_rx()
    gnss_check_incoming does memcmp(), else if ladder replaced with switch statement, common lines moved outside switch statement
    [gnss.c, gnss.h]
2024-02-03 Print both short and long term averages for CLKD
    [pic_pps.c]
2024-02-03 Move uart1 handling to esp.c
2024-02-03 Move UART1 to interrupt and fix dumb MCC behaviour
    User code is called BEFORE character is received into buffer, rather than after, for some reason.
    [main.c, uart1.c, uart1.h, uart2.c]
2024-02-03 Add esp_rx function for UART1 interrupt
2024-02-04 Change GNSS fix timeout to 30s from 120s
    [gnss.h]
2024-02-04 Added timer to determine NTP offset from GNSS
2024-02-04 Moved esp sync timer reset to OC interrupt
    [pic_pps.c, pic_pps.h, sync_state.c]
2024-02-04 Fix typo in printf for esp_print_offset
    [esp32.c]
2024-02-05 Increase uart1 buffer size
    Buffer overrun on repetitive printing. Needs more elegant solution
2024-02-06 Update to print_ubx_nav_status_data()
2024-02-07 ESP time/net state bugfix and clean up
    [esp32.c]
2024-02-10 Added NTP sync adjust state
    Tidied up prototype functionality in 2c0fda078c8c6f5b9cdc0e283533f74aaee32ad2
2024-02-11 Faster time acquisition
    No longer waits for GNSS fix if GNSS is detected. Enters 'best' time source state and when GNSS is valid, begins normal operation.
    [sync_state.c]
2024-02-11 Rename NTP and RTC modes
    No longer use "ONLY" as they may be entered even when GNSS is detected but not valid
    [sync_state.c, sync_state.h]
2024-02-11 Properly break after GNSS fix acquired
    [sync_state.c]
2024-02-12 Removed debugging printing from ESP
2024-02-12 Tidied up printing of NTP offset info
2024-02-12 Consolidated UTC/GNSS/NTP time printing
    Now prints at UTC+50ms. NTP can now be detected as stale before ESP is deemed missing.
    [esp32.c, sync_state.c]
2024-02-13 power_on_time now accurately determined via NTP
    Now determined through either NTP or GNSS. Syncing NTP first would mean power_on_time was never set as gnss_calendar_sync was only called if UTC did not match GNSS.
2024-02-15 Auto brightness from ESP light sensor
    Including smoothing function, a 'target' brightness variable, and some helper functions for future manual override.
2024-02-24 Updated ESP32 pin numbers to match new board
2024-02-24 Set tubes to default brightness if no ESP
2024-02-24 Increased PIC/ESP UART speed to 921600
2024-02-26 Reduce baud rate to 460800 due to rats nest wiring
2024-03-08 New board, new clock!
    Change to 40MHz oscillator
2024-03-08 Remove sensor code from ESP32 for now
2024-03-08 Back to 115200 baud on uart
2024-03-09 Add gnss_config.txt
    [gnss_config.txt]
2024-03-10 Add i2cscanner.ino
2024-03-10 Use ESP_PPS pin for NTP offset calculation
2024-03-11 FIXED THE PCF8563 DRIVER
    Apparently it just sets unused bits randomly? Solar flares perhaps?
    [i2c1.c, pcf8563.c, rtc.c]
2024-03-11 Track ESP time in addition to NTP time
2024-03-11 VEML6040 lux sensor added
    Basic driver + implementation + calibration
2024-03-12 Add rtc_valid flag in case of RTC power loss
2024-03-15 Only flash ESP LED when we have time set
2024-03-16 bme280 prototype functions
2024-03-24 Fix the DST function...
    DST is dumb and I hate it
    [tubes.c]
2024-03-24 Fix all the i2c compiler warnings
    [ds1307.c, pcf8563.c, sht30.c, veml6040.c]
2024-03-25 Only print GNSS offset if it's detected
2024-03-25 Basic BME280 driver
    Heavily based on boschsensortec/BME280_SensorAPI/
2024-03-25 Added temperature offset value
    Board gets warm, however this means the humidity reading is also junk
2024-03-26 Temperature display
2024-03-26 Basic temperature readings
2024-03-26 Improve clock switching behaviour
2024-03-26 Better printing of BME280 data
2024-03-26 Simplified UBX data printing
2024-04-02 Serial command to reset WiFi credentials
    [esp_src.ino]
2024-04-02 Add function to print some ESP data if available
2024-04-02 Added fallback if ESP loses wifi/sync/power/sanity
2024-04-04 Only print NTP offset from GNSS when syncd
2024-04-13 Only print human readable messages when in debug
2024-04-14 Added symlinks because Arduino is dumb
2024-04-14 First cut ESP receiving PIC data
2024-04-19 Update to ESP serial proto
    Print some data when requested on 'Z'
2024-04-21 Improved print_clocks()
2024-04-21 Print offsets on Z when status is not timeNotSet
2024-04-27 New function print_pic_local_time()
2024-04-27 Print local time each second
2024-04-27 Change to time printing
    Wait for 50ms for messages to come in, rename print_pic_local_time() to print_local_time() and add singular time_t argument to it. Add variables in preparation for obtaining tz/dst info from the internet.
2024-04-28 Change printing format of ESP offsets
2024-04-28 Fix compiler warning for uart1.c
    [uart1.c]
2024-04-29 Tighten defines for ESP_NTP_OFFSET values
    [esp32.h]
2024-05-04 Show switch state in count and temp display mode
2024-05-04 Display always times out in temp or menu mode
    Regardless of switch state, clock should return to default display from temp display or menu
2024-05-05 Fixed weird ssmm bug
    [tubes.c]
2024-05-11 Cache correct previous_display time
    [tubes.c]
2024-05-13 Improve ui_state_current readability
    More switch, less else if
2024-05-21 Fix ESP code broken by last commit
    [pic_serial_proto.ino]
2024-05-24 Fix secondschanged() edge case
    Only call UTC.now() in once place. eztime modified to allow multiple .ms() calls without affecting SecondsChanged() result.
    [esp_src.ino, pic_serial_proto.ino]
2024-05-24 Fix strange GNSS fix but no WiFi corner case
    Strange race condition in the pin ISR when calliing UTC.ms()... I think?
    [esp_src.ino, pic_serial_proto.ino]
2024-05-25 Buzzer code overhaul
    Code now no longer requires reverse engineering each time I read it
    [ui.c, ui.h]
2024-05-25 Reset DST offset to default when select auto DST
    [ui.c, ui.h]
2024-05-27 Removed debugging printing
2024-05-27 Alarm now cancels on long button press
2024-05-27 Fix display setting menu
    [ui.c]
2024-05-27 Clock now remembers settings over reboot
    Using program memory as EEPROM
    [eeprom.c, eeprom.h, ui.c]
2024-05-27 Check reset vars too
    [eeprom.c]
2024-05-28 Auto re-arm alarm if switch is enabled
2024-05-28 Reset alarm when edited
    [ui.c]
2024-07-22 Multiple fixes, display menu integration
    Way of setting it pending...
    [eeprom.c, tubes.c, ui.c, ui.h]
2024-08-03 Fix RTC validity display
    [esp32.c, pic.cpp, sync_state.c]
2024-08-04 Fix get_local_time()
    DST is applied at UTC, not local time (for GB/EU at least)
    [tubes.c]
2024-08-04 Move serial proto headers to non alphanumeric
    Can now print lowercase p from the pic
2024-08-17 Add hardware folder for v2.0
    [smol_clock_2_0_bom_bottom.xlsx, smol_clock_2_0_bom_top.xlsx, smol_clock_2_0_pnp_bottom.xlsx, smol_clock_2_0_pnp_top.xlsx]
2024-09-18 Port to arduino-esp32 v3.0.x
2024-09-19 Explicitly set time_t to 32 bits in serial_proto.h
    arduino-esp32 3.0.x changed default behaviour to 64 bit. Left some debug code in but commented out.
2024-09-28 Use printf in esp
2024-10-07 User proper ARDUINO_ISR_ATTR macro
2024-12-14 Improve missing GNSS PPS handling
    [esp32.c, gnss_pps.c, pic.cpp, pic_pps.c, pic_pps.h, sync_state.c]
2024-12-14 Minor PPS missing detection improvements
    [pic_pps.c, sync_state.c]
2025-01-14 YYYY and MMDD modes now correctly use local time
    [ui.c]
2025-01-15 Only flash LED if ESP is synced AND connected
2025-01-31 Print localIP as c_str()
2025-02-01 Revert some UART changes so PuTTY works again
    [user_uart.cpp]
2025-02-01 Seems to fix strange behaviour, needs checking
    Bizarre behaviour where ESP status led fails to light up on secondChanged(), but adding a printf statemnet seems to fix it? So bodge a delayMicroseconds() fix for now. SUspect some sort of race condition
    [esp_src.ino]
2025-02-02 Fix stupid `secondsChanged()` bug
    Remove all ms() calls to stop blocking code overrunning the ezTime code
    [esp_src.ino]
2025-02-16 WPA3-PSK no longer shown as OPEN
    [serial_console.cpp]
2025-09-14 Read both IC values in the same ISR
    Plus bonus 32bit timer experiment (commented out)
2025-12-11 Save previous fosc_freq to eeprom
    Potentially allows for better initial accuracy after reboot.
    [eeprom.c, eeprom.h, gnss_pps.c, gnss_pps.h, main.c]
2025-12-12 Fixed floating point fosc disp limitation
    [pic.cpp, pic_pps.c]
2025-12-12 Reset sync states on clock select
    [sync_state.c]
2025-12-14 Add partitions.csv
    Set up partitions for 8MB flash. 3MB app x2 for OTA and 1.5MB SPIFFS
    [partitions.csv]
2025-12-31 Disable telnet by default
    Use USB UART to enable
2025-12-31 memset 0 entire user prefs struct on reset
    Rather than just individual strings multiple times
    [user_prefs.cpp]
2025-12-31 Add print_ntp_info()
    Prints NTP info by default on /n
2025-12-31 Add strcmp statement for esp-tzinfo-set-interval
    Bug fix
    [serial_console.cpp]
2025-12-31 Set tzinfo interval counter correctly
    Will now always check at either power on or after being enabled.
    [remote_tzinfo.cpp, serial_console.cpp]
2025-12-31 Update serial_console.cpp
    Fix typo
    [serial_console.cpp]
2026-04-17 Remove blocking i2c operations
2026-07-03 Fix dumb UART problems
    UBX parser fell over when U2RX interrupt didn't order the bytes properly so it never matched after fault
    [gnss.c, gnss.h, uart2.c, ublox_ubx.c]
2026-07-03 Fixed UART1 driver
    Same problem as UART2
    [uart1.c]
2026-07-07 More UART diagnostics
2026-07-25 Add pic_uart_usb esp32 util
2026-10-11 Reorg of dspic_src
    Moving drivers to their own folder to reduce clutter
2026-10-19 Huge rewrite, master epoch architecture
    Hopefully this will not also turn into spaghetti code like the last version. Binned off all the MCC code. Core timing and display is there. Still need to implement new ESP-PIC SML UART protocol, i2c, and the majority of the UI features.
2026-10-20 ESP rewrite
    Bulk cleanup of the ESP spaghetti code, and implementation of new NTP client and SML uart protocol.
2026-10-20 Expand edge capture to NTP ESP PPS pin
    Remap IC1/2 to NTP PPS pin when GNSS is not in use. Add some additional debug and sync ocnditions. Sometimes OC sync will be off by one at boot. Take some measurements and either adjust for it or wait for good sync.
2026-10-21 I2C and PCF8563 drivers
    Hopefully better than the MCC I2C driver.
2026-10-21 Increase SML-STAT-SYS rate to 1Hz
2026-10-26 Re-implement flash storage and VEML6040 driver
    Autobrightness by default
2026-10-26 Added ui service for button/switch
2026-10-26 Changes to flash reservations
    V2plus no longer fits in <50% of PIC flash, so dual slot application is not possible.
2026-10-28 Reimplement display modes
    Remove temperature mode (useless due to board heating), and add uncertainty display.
2026-10-28 Reimplemented alarm, changes to delta setting
    Delta mode epoch can now be set with time string, not just epoch value. There's some guesswork about precise local time if this falls outside the current timezone horizon stored. v2 of tzinfo will make a lookup if enable to determine exact utc to be stored.
2026-10-29 Account for crystal drift + print to 4sf
    Previous RTC measurements forgot to account for crystal drift, instead using nominal frequency. Now corrected.
2026-10-30 Track version.h in MPLAB
2026-10-31 Disable ESP power save for better NTP accuracy
